megan4977/7404337_RZ_G2_HW/DesignDocs/LiveFireSLA/closebattcontact.jpg

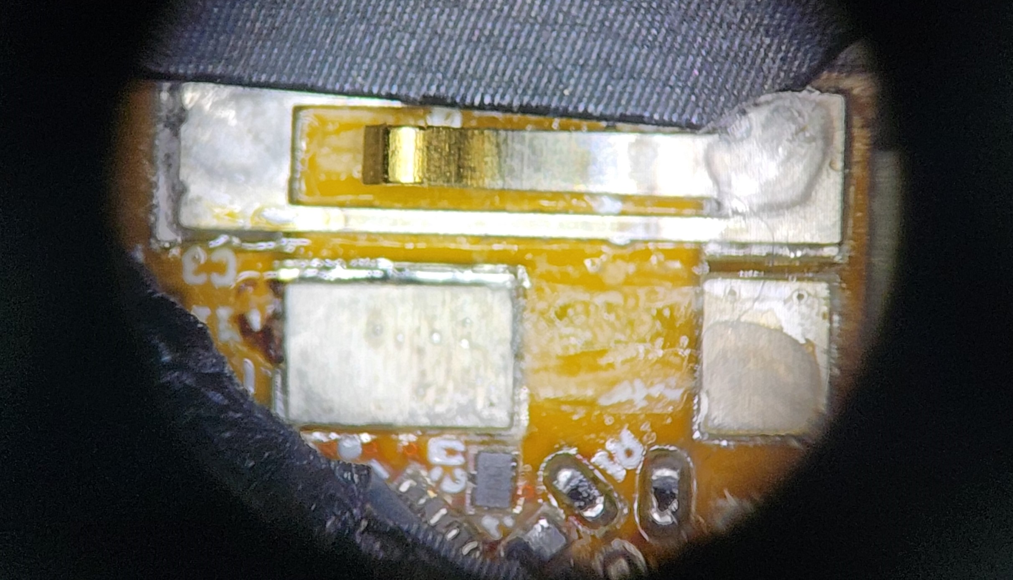
DesignDocs/LiveFireSLA/closebattcontact.jpg
