megan4977/7404337_RZ_G2_HW/AltiumProject/Project Outputs/FAB/ReadMe.txt

The FabOutputs.PDF does not show the solder mask (coverlay) cut outs or solder paste for D1. Please refer to gerbers.
The 3D images in FabOutputs.PDF do not show the cutout in the stiffener. Please refer to the drawing for that info.
The Gerbers do not show the stiffener cutout please refer to the drawing for that info.
