megan4977/7404337_RZ_G2_HW/AltiumProject/Project Outputs/7404337_RZ_G2_DesignRule.PDF

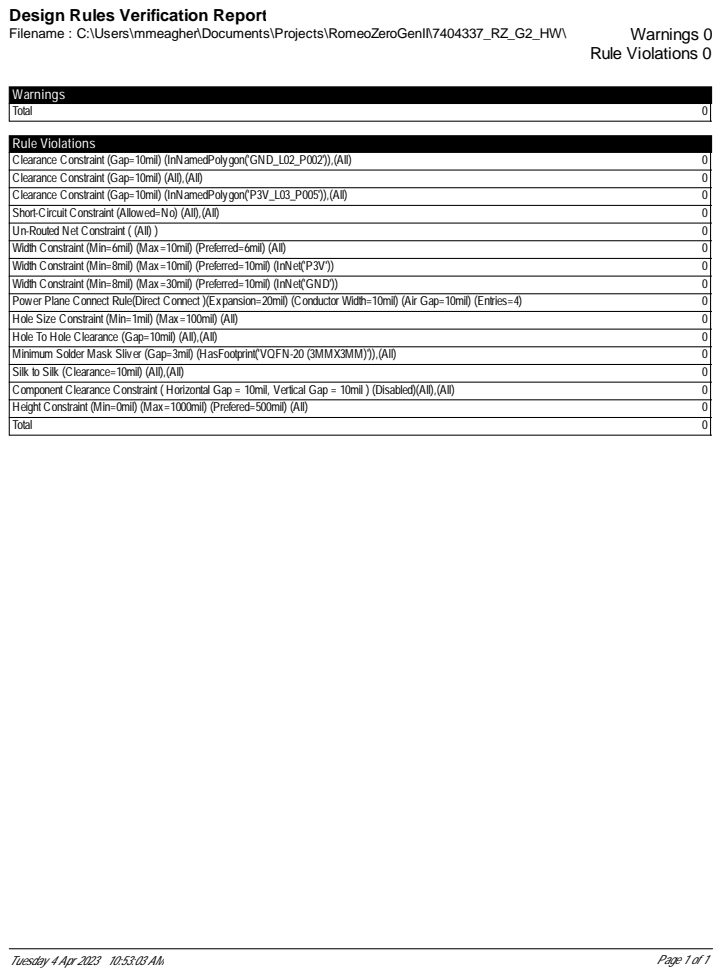
[picture p19: page 1]

Design Rules Verification Report

### Electrical Rules Check Report

Class | Document | Message
Warning | 7404337_RZ_G2.SchDoc | Off grid Pin J2-3 at 1849.537mil,5103.987mil
Warning | 7404337_RZ_G2.SchDoc | Off grid Pin J2-4 at 1853.661mil,5002.953mil
Tuesday 4 Apr 2023 10:53:04 AM | Page 1 of 1

No differences were detected.
