megan4977/7404337_RZ_G2_HW/DesignDocs/Stackup_7404337.xls

 |  | A (MAIN) | B (FLEX) | D (LED) |  | A | B | C | D
Layers
Black cover film | PI | YELLOW COVERLAY |  |  | 25 | 25 | 25
 | AD |  |  |  | 25 | 25 | 25
Copper plating 2 | PLATING | 2nd Cu Plating |  |  | 18 | 18 | 18
Copper plating 2 | CU | Electro Deposited Cu |  |  | 18 | 18 | 18
Double-sided substrate (G3/GBL) | PI |  |  |  | 25 | 25 | 25
 | CU | Electro Deposited Cu |  |  | 18 | 18
 | AD |  |  |  | 25 | 25
Copper plating 1 | PI |  | Black Coverlay |  | 25 | 25 | 25 | 25 | 25
Black cover film | AD |  |  |  | 25 | 25 | 25 | 25 | 25
 | PLATING | 1st Cu Plating |  | 1st Cu Plating | 15 | 15 | 15 | 15 | 15
Pure glue | CU | Electro Deposited Cu |  | Electro Deposited Cu | 18 | 18 | 18 | 18 | 18
Double-sided substrate (G3/GBL) | PI |  |  |  | 25 | 25 | 25 | 25 | 25
 | CU | Electro Deposited Cu |  | Electro Deposited Cu | 18 | 18 | 18 |  | 18
 | PLATING | 1st Cu Plating |  | 1st Cu Plating | 15 | 15 | 15 |  | 15
Copper plating 2 | PLATING | 2nd Cu Plating |  | 2nd Cu Plating | 18 | 18 | 18 |  | 18
Yellow cover film | AD |  |  |  | 25 | 25 | 25 | 25 | 25
 | PI | YELLOW COVERLAY | Black Coverlay |  | 25 | 25 | 25 | 25 | 25
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
