megan4977/7404337_RZ_G2_HW/DesignDocs/To Do.xlsx

Need to determine if the restitors R9 and R10 need different values for dot version of board | Done | swapped dot and cd resistors
need to develop FW for ID function to use same FW for dot/vs circle dot | Done | working
Determine if we can use all black coverlay | Done
create a test plan | Done
review open items from the dfmea | Done
never received confirmation on battery hours | Done
Verify what Attiny versions our fw can fit into
test switch mechanicals to make sure we can't push it off the board
Clean up the current FW to be more modular and make sense
put together a cost analysis of having vendor program and test vs the line programming and testing
move silk to bottom of stiffenere instead of bottom of board
add test point for checking accelerometer
get current measurements
Test out current draw when setting up pins to be outputs driven low or high vs setting to inputs with input buffer disabled and I think you also have to enable the pull up
remove componenets on dot board and test fully
in reticle.c enable LED needs max turned of for unused segments this might already be handled in set Max gear double check on actual board
Boards wrong color
Boards not trimmed at top
Under accelrometed doesn’t have mask not sure if it can
Pin not attached to anything come of easy and need anchor
Transitor needs pin 1 silk
All pin 1 silks need better marking
Possibly add anchoring to the battery pads
Modify the coverlay cutouts to provide anchors see image
Get John a board with new FW to check
See if this code can fit into other Attiny's if so complile FW for it
make sure drawing shows sticker on LED
need to check with don on how to fix drill chart
make sure that the pin setup is correct for the inputs lowest current mode don't want issues like auto off
need to add testing CD dot and circle all separately on the test plan
dot is'nt showing up on the lowest setting when in dot only is on for CD
dot looks like it still has some leakage on PQ5 especially if you look at the low settings on a black background
test out the hardware.c settings
need test instructions
Update layout with drews last drawing that include the cutout then send him step
upate the transistor land pattern with the drawings herb sent
Fix FW pin setup
