megan4977/7404337_RZ_G2_HW/DesignDocs/LiveFireSLA/CloseR.jpg

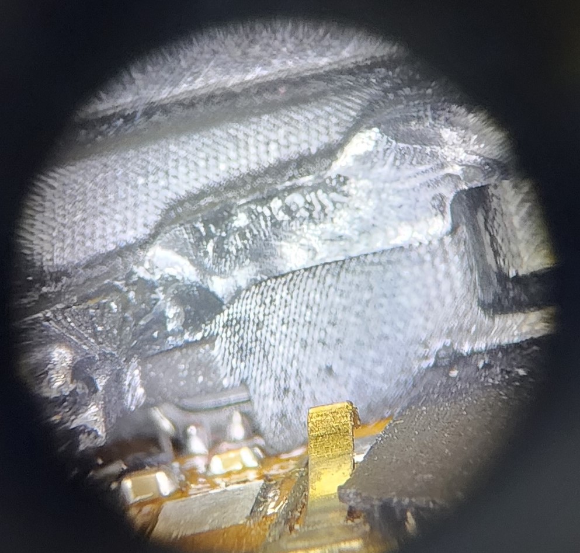
DesignDocs/LiveFireSLA/CloseR.jpg
