megan4977/7404337_RZ_G2_HW/DesignDocs/LiveFireSLA/fullcase.jpg

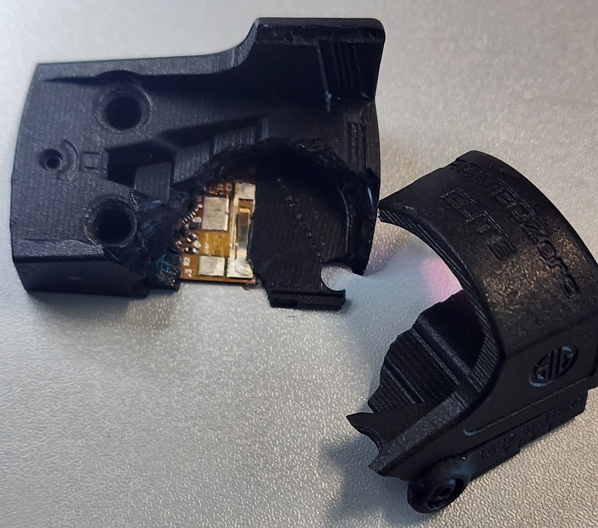
DesignDocs/LiveFireSLA/fullcase.jpg
