megan4977/7404337_RZ_G2_HW/DesignDocs/LiveFireSLA/necktwisted.jpg

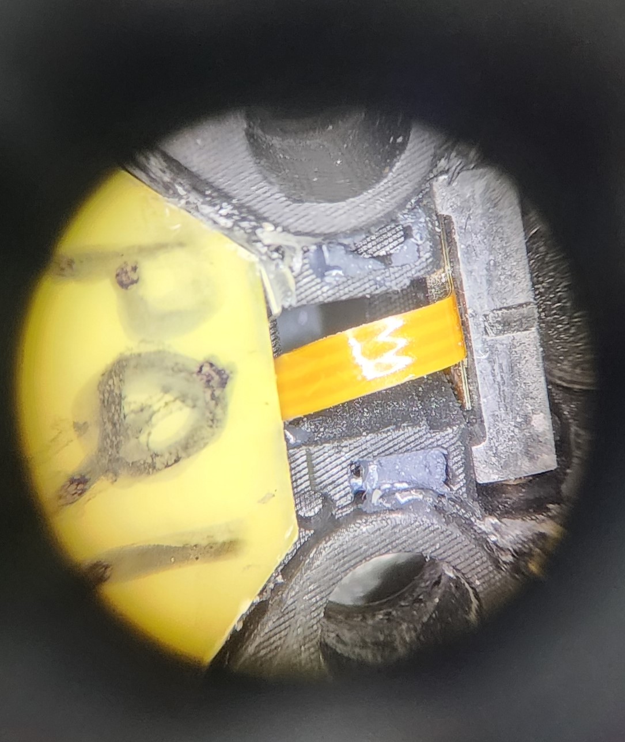
DesignDocs/LiveFireSLA/necktwisted.jpg
