megan4977/7404337_RZ_G2_HW/DesignDocs/LiveFireSLA/partial case.jpg

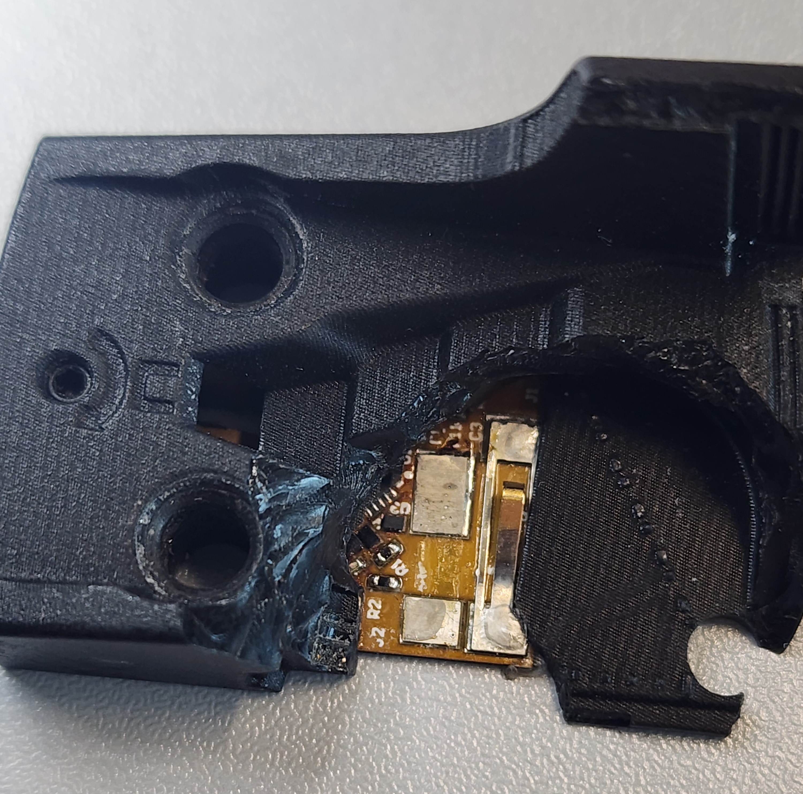
DesignDocs/LiveFireSLA/partial case.jpg
