megan4977/7404337_RZ_G2_HW/DesignDocs/summitLayout.jpg

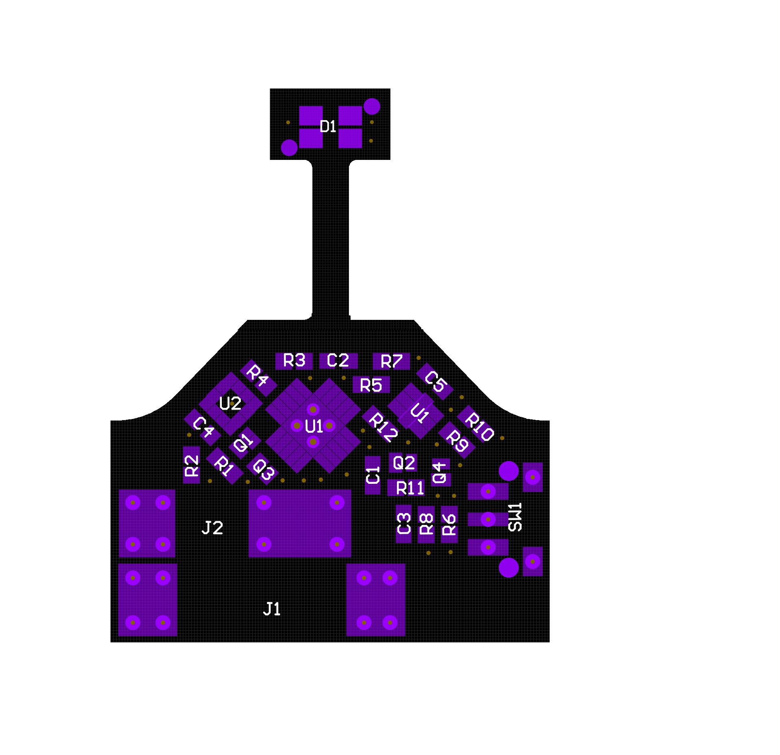
DesignDocs/summitLayout.jpg
