megan4977/7404337_RZ_G2_HW/AltiumProject/Project Outputs/7404337-01_3MOA/ASSY/Bill of Materials-7404337_RZ_G2(7404337-01_3MOA).xlsx

Designator | Quantity | Description | Manufacturer | Value | MPN | Distributor | DPN
C1 | 1 | CAP CER 10UF 10V 20% X5R 0402 | Samsung | 10uF/10V | CL05A106MP5NUNC | Digi-key | 1276-1450-2-ND
C3 | 1 | CAP CER 0.047UF 25V X7R 0402 .55mm max | Murata | 47nF | GRM155R71E473KA88D | Digi-key | 490-3254-2-ND
C4, C5 | 2 | CAP CER 0.1UF 16V X7R 0402 | Murata | 0.1uF | GRM155R71C104KA88D | Digi-key | 490-3261-2-ND
D1 | 1 | LED Jenoptik 25um red | Jenoptik |  | ELM-650-992-025-2 | Jenoptik | ELM-650-992-025-2
FW1 | 1 | FW for 7404337 Romeo Zero Gen II
J1 | 1 | Battery contact, Kyocera, 70-9155-001-615-004 | Kyocera | R0 contact pos | 70-9155-001-615-004
J2 | 1 | Sig Custom Battery contact, custom RZGENII CR1632 Positive | SIG | R0 contact pos | 7401598
J3 | 1 | Connector for pwr, gnd, prgm, sw, accel
Q3, Q4 | 2 | MOSFET P-CH 20V 770MA 3DFN | Diodes Incorporated |  | DMP21D0UFB4-7B |  | MOSFET P-CH 20V 770MA 3DFN
R3, R4 | 2 | RES 4.7K OHM 1% 1/16W 0402 | Yageo | 4.7K | RC0402JR-074K7L | Digi-key | 311-4.7KJRTR-ND
R6 | 1 | RES 3M OHM 5% 1/16W 0402 100ppm | Yageo | 3M | RC0402JR-073ML | Digi-key | 311-3.0MJRTR-ND
R7, R8 | 2 | RES 1M OHM 5% 1/16W 0402 100ppm | Yageo | 1M | RC0402JR-071ML | Digi-key | 311-1.0MJRTR-ND
R9 | 1 | RES SMD 1.02K OHM 1% 1/16W 0402 | Yageo | 1.02K | RC0402FR-071K02L | Digi-key | YAG3029CT-ND
R10 | 1 | 80.6 kOhms ±1% 0.063W, 1/16W Chip Resistor 0402 | Yageo | 80.6K | RC0402FR-0780K6L | Digi-key | 311-80.6KLRCT-ND
R11, R12 | 2 | RES 0OHM 1% 1/16W 0402 | Yageo | 0 | RC0402JR-070RL | Digi-key
R13 | 1 | RES SMD 20K OHM 1% 1/16W 0402 | Yageo | 20K | RC0402FR-0720KL | Digi-key | 311-20.0KLRCT-ND
SW1 | 1 | SWITCH TACTILE SPST-NO 0.05A 12V
U1 | 1 | IC MCU 8BIT 16KB FLASH 20VQFN | Microchip | ATTINY1616 | ATTINY1616-MNR | Digikey | ATTINY1616-MNRCT-ND
U2 | 1 | Accelerometer X, Y, Z Axis 12VFLGA | STMicroelectronics |  | LIS2DE12TR | Digi-key | 497-15997-1-ND
U3 | 1 | IC CMOS 2 CIRCUIT 8X2QFN | Texas Instruments | TLV8542 | TLV8542RUGR | Digikey | 296-50282-1-ND
