megan4977/7404337_RZ_G2_HW/AltiumProject/7404337_RZ_G2.step

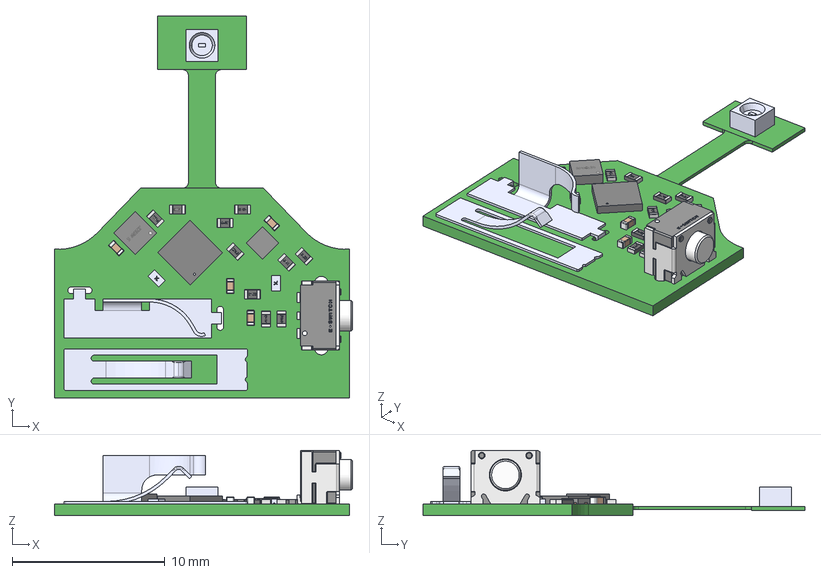
[picture p25: CAD file, 2023-04-04]
AltiumProject/7404337_RZ_G2.step
19.5 x 25.0 x 4.26 mm
VQFN20_3X3_MCH
7404338 REV00 230315
User Library-0402R x 10
RZCD_ELM65099212
TLV8542RUG0008A
CAP_0402 x 4
LIS2DW12
button
terminals
logo
SOT883B4 LF x 2
SOT883B Mold body x 2
70-9155-001-615-00X
