megan4977/7404337_RZ_G2_HW/AltiumProject/Import_Export/7404337_RZ_230315.STEP

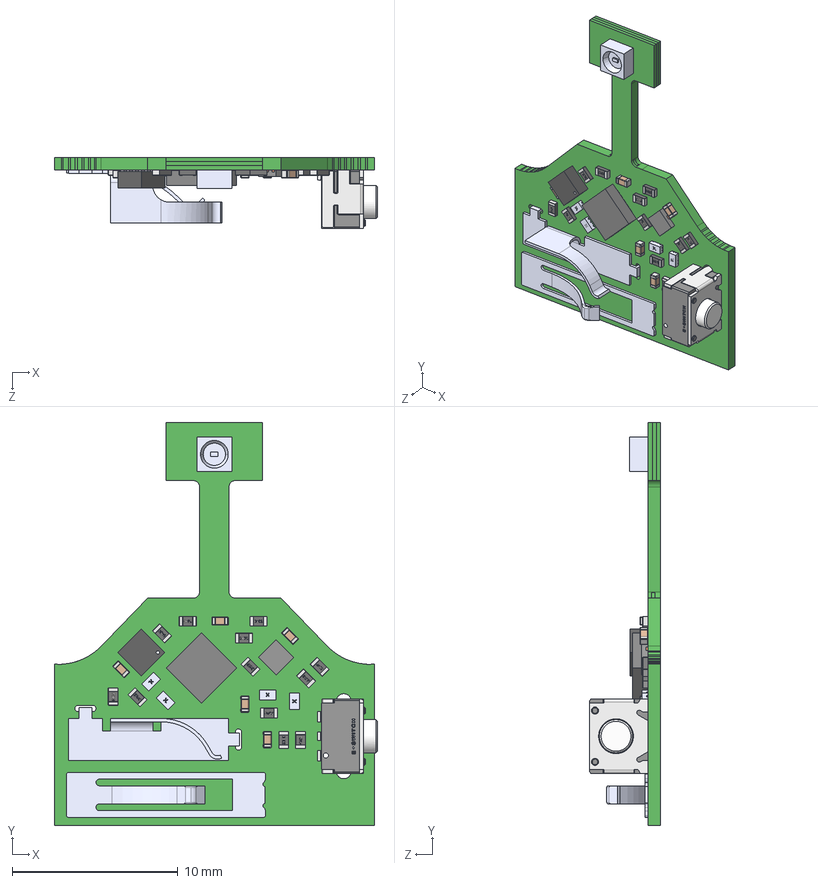
[picture p26: CAD file, 2023-04-04]
AltiumProject/Import_Export/7404337_RZ_230315.STEP
19.5 x 24.3 x 4.29 mm
RZCD_ELM65099212.step
User Library-0402R.step x 12
TLV8542RUG0008A.step
CAP_0402.step x 5
VQFN20_3X3X0R9.step
SOT883B4 LF.step x 4
SOT883B Mold body.step x 4
STLIS2DE12LGA12_2x2x1.step
body.step
shell.step
button.step
terminals.step
logo.step
70-9155-001-615-00X.step
