megan4977/7404337_RZ_G2_HW/AltiumProject/Import_Export/Models/7404338 REV00.STEP

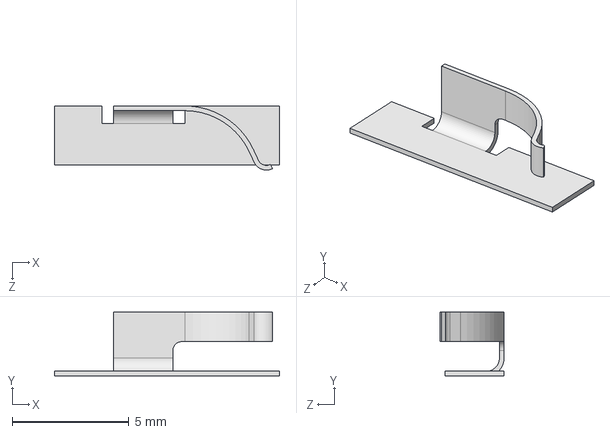
[picture p27: CAD file, 2023-04-04]
AltiumProject/Import_Export/Models/7404338 REV00.STEP
9.65 x 2.74 x 2.75 mm
