megan4977/7404337_RZ_G2_HW/AltiumProject/Import_Export/7404338 REV00 230315.STEP

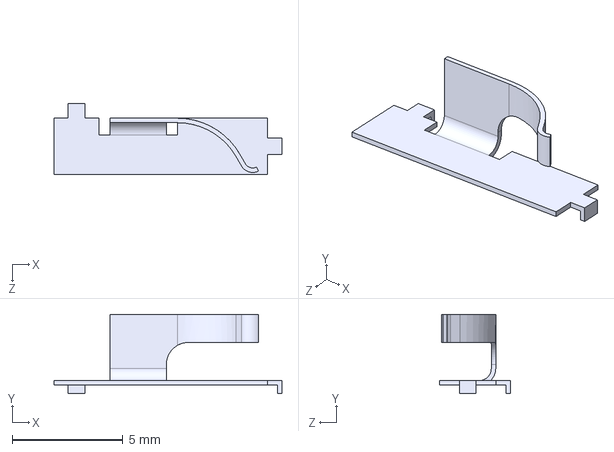
[picture p28: CAD file, 2023-04-04]
AltiumProject/Import_Export/7404338 REV00 230315.STEP
10.3 x 3.58 x 3.20 mm
