megan4977/7404337_RZ_G2_HW/AltiumProject/Import_Export/7404337 221219.DXF

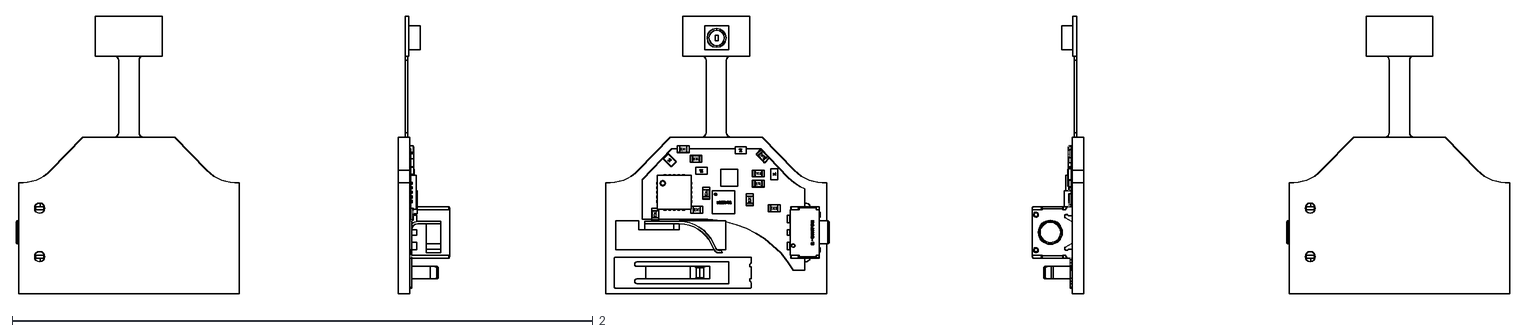
[picture p29: CAD file, 2023-04-04]
AltiumProject/Import_Export/7404337 221219.DXF
5.14 x 0.957
