megan4977/7404337_RZ_G2_HW/AltiumProject/Import_Export/7404337 221212.DXF

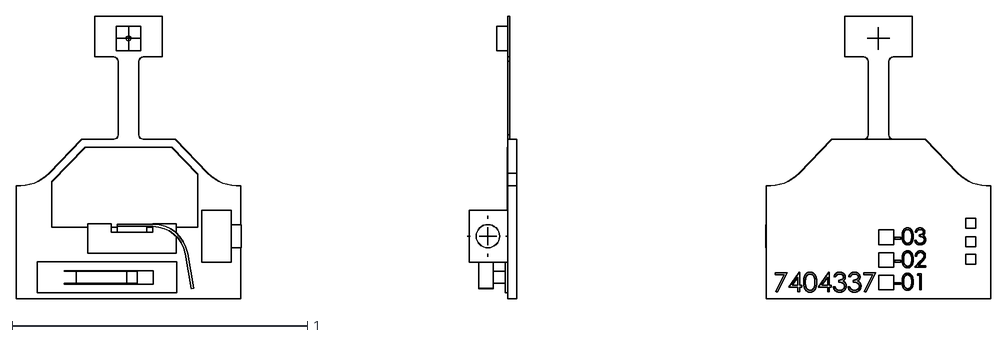
[picture p31: CAD file, 2023-04-04]
AltiumProject/Import_Export/7404337 221212.DXF
3.30 x 0.957
