megan4977/7404337_RZ_G2_HW/AltiumProject/Import_Export/7404337 230327.DXF

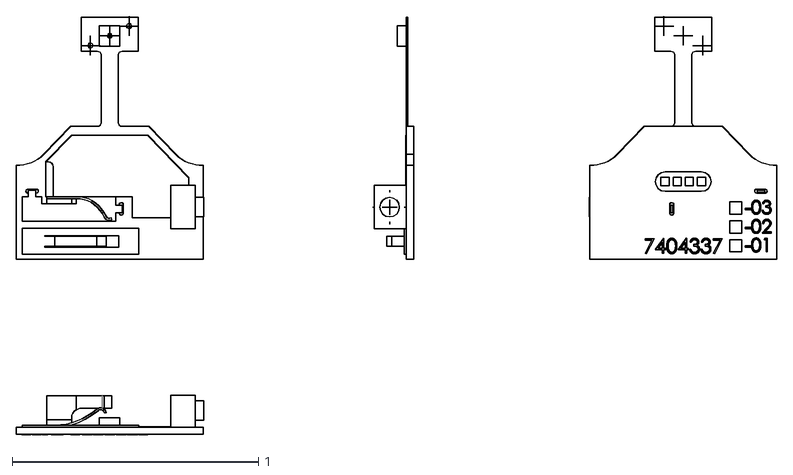
[picture p32: CAD file, 2023-04-04]
AltiumProject/Import_Export/7404337 230327.DXF
3.09 x 1.70
