megan4977/7404337_RZ_G2_HW/AltiumProject/Import_Export/7404337 REV00.DXF

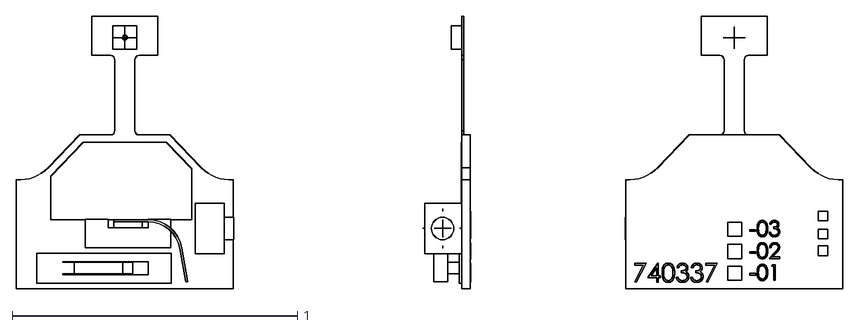
[picture p34: CAD file, 2023-04-04]
AltiumProject/Import_Export/7404337 REV00.DXF
2.90 x 0.957
