megan4977/7404337_RZ_G2_HW/AltiumProject/Import_Export/7404337_RZ_G2_PADS.DXF

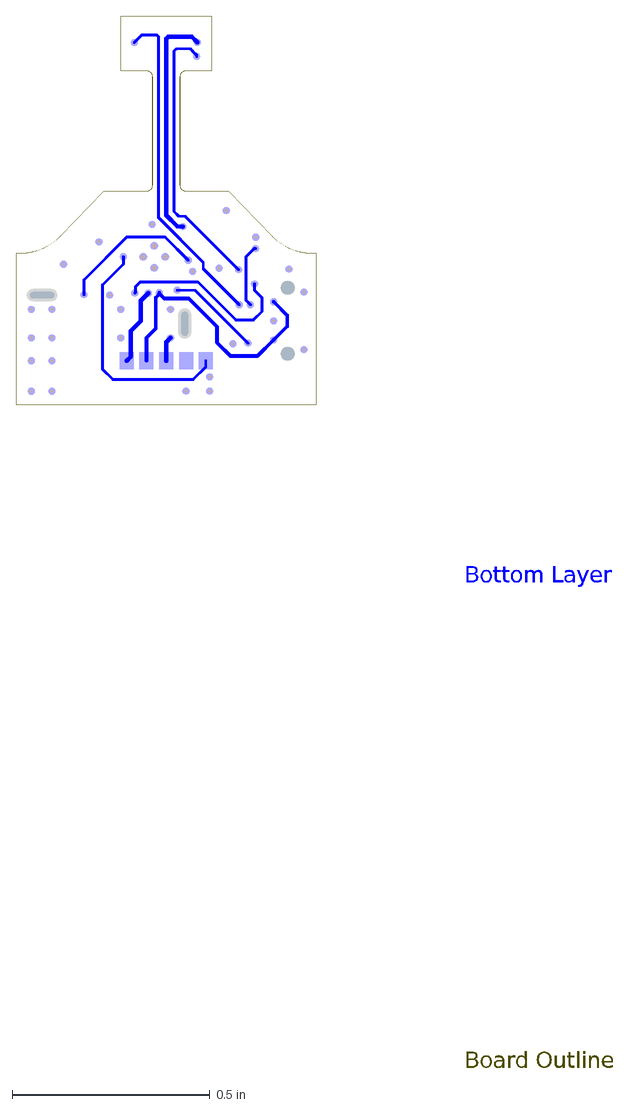
[picture p35: CAD file, 2023-04-04]
AltiumProject/Import_Export/7404337_RZ_G2_PADS.DXF
Bottom Layer
Board Outline
