megan4977/7404337_RZ_G2_HW/AltiumProject/Import_Export/7404337 REV00 230126.DXF

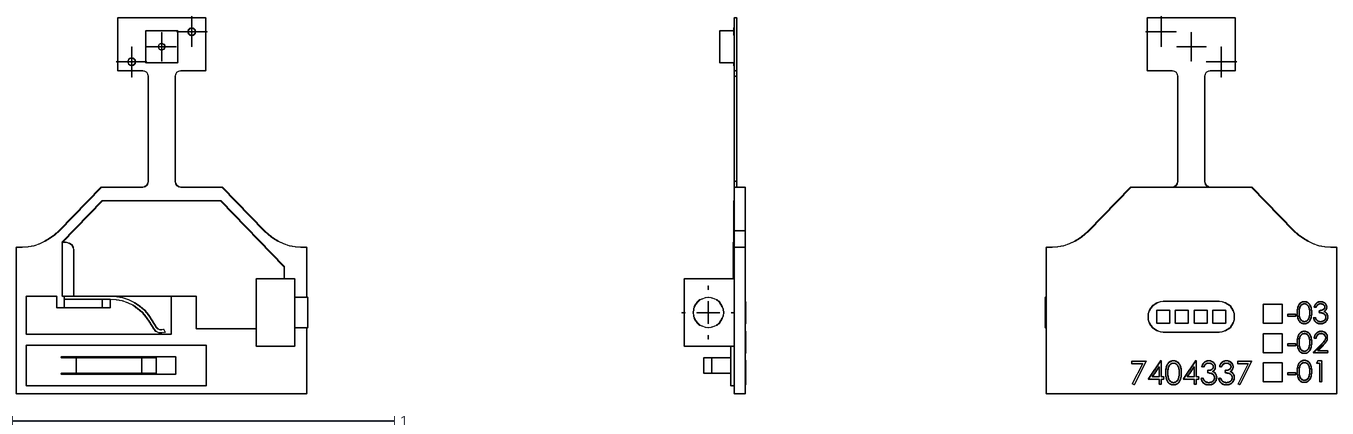
[picture p36: CAD file, 2023-04-04]
AltiumProject/Import_Export/7404337 REV00 230126.DXF
3.45 x 0.987
