megan4977/7404337_RZ_G2_HW/(list of files, cad)

Other CAD files:
AltiumProject/Import_Export/7404337_RZ_G2.step
