megan4977/7404337_RZ_G2_HW/AltiumProject/Project Outputs/7404337-01_3MOA/ASSY/Schematic Prints.PDF

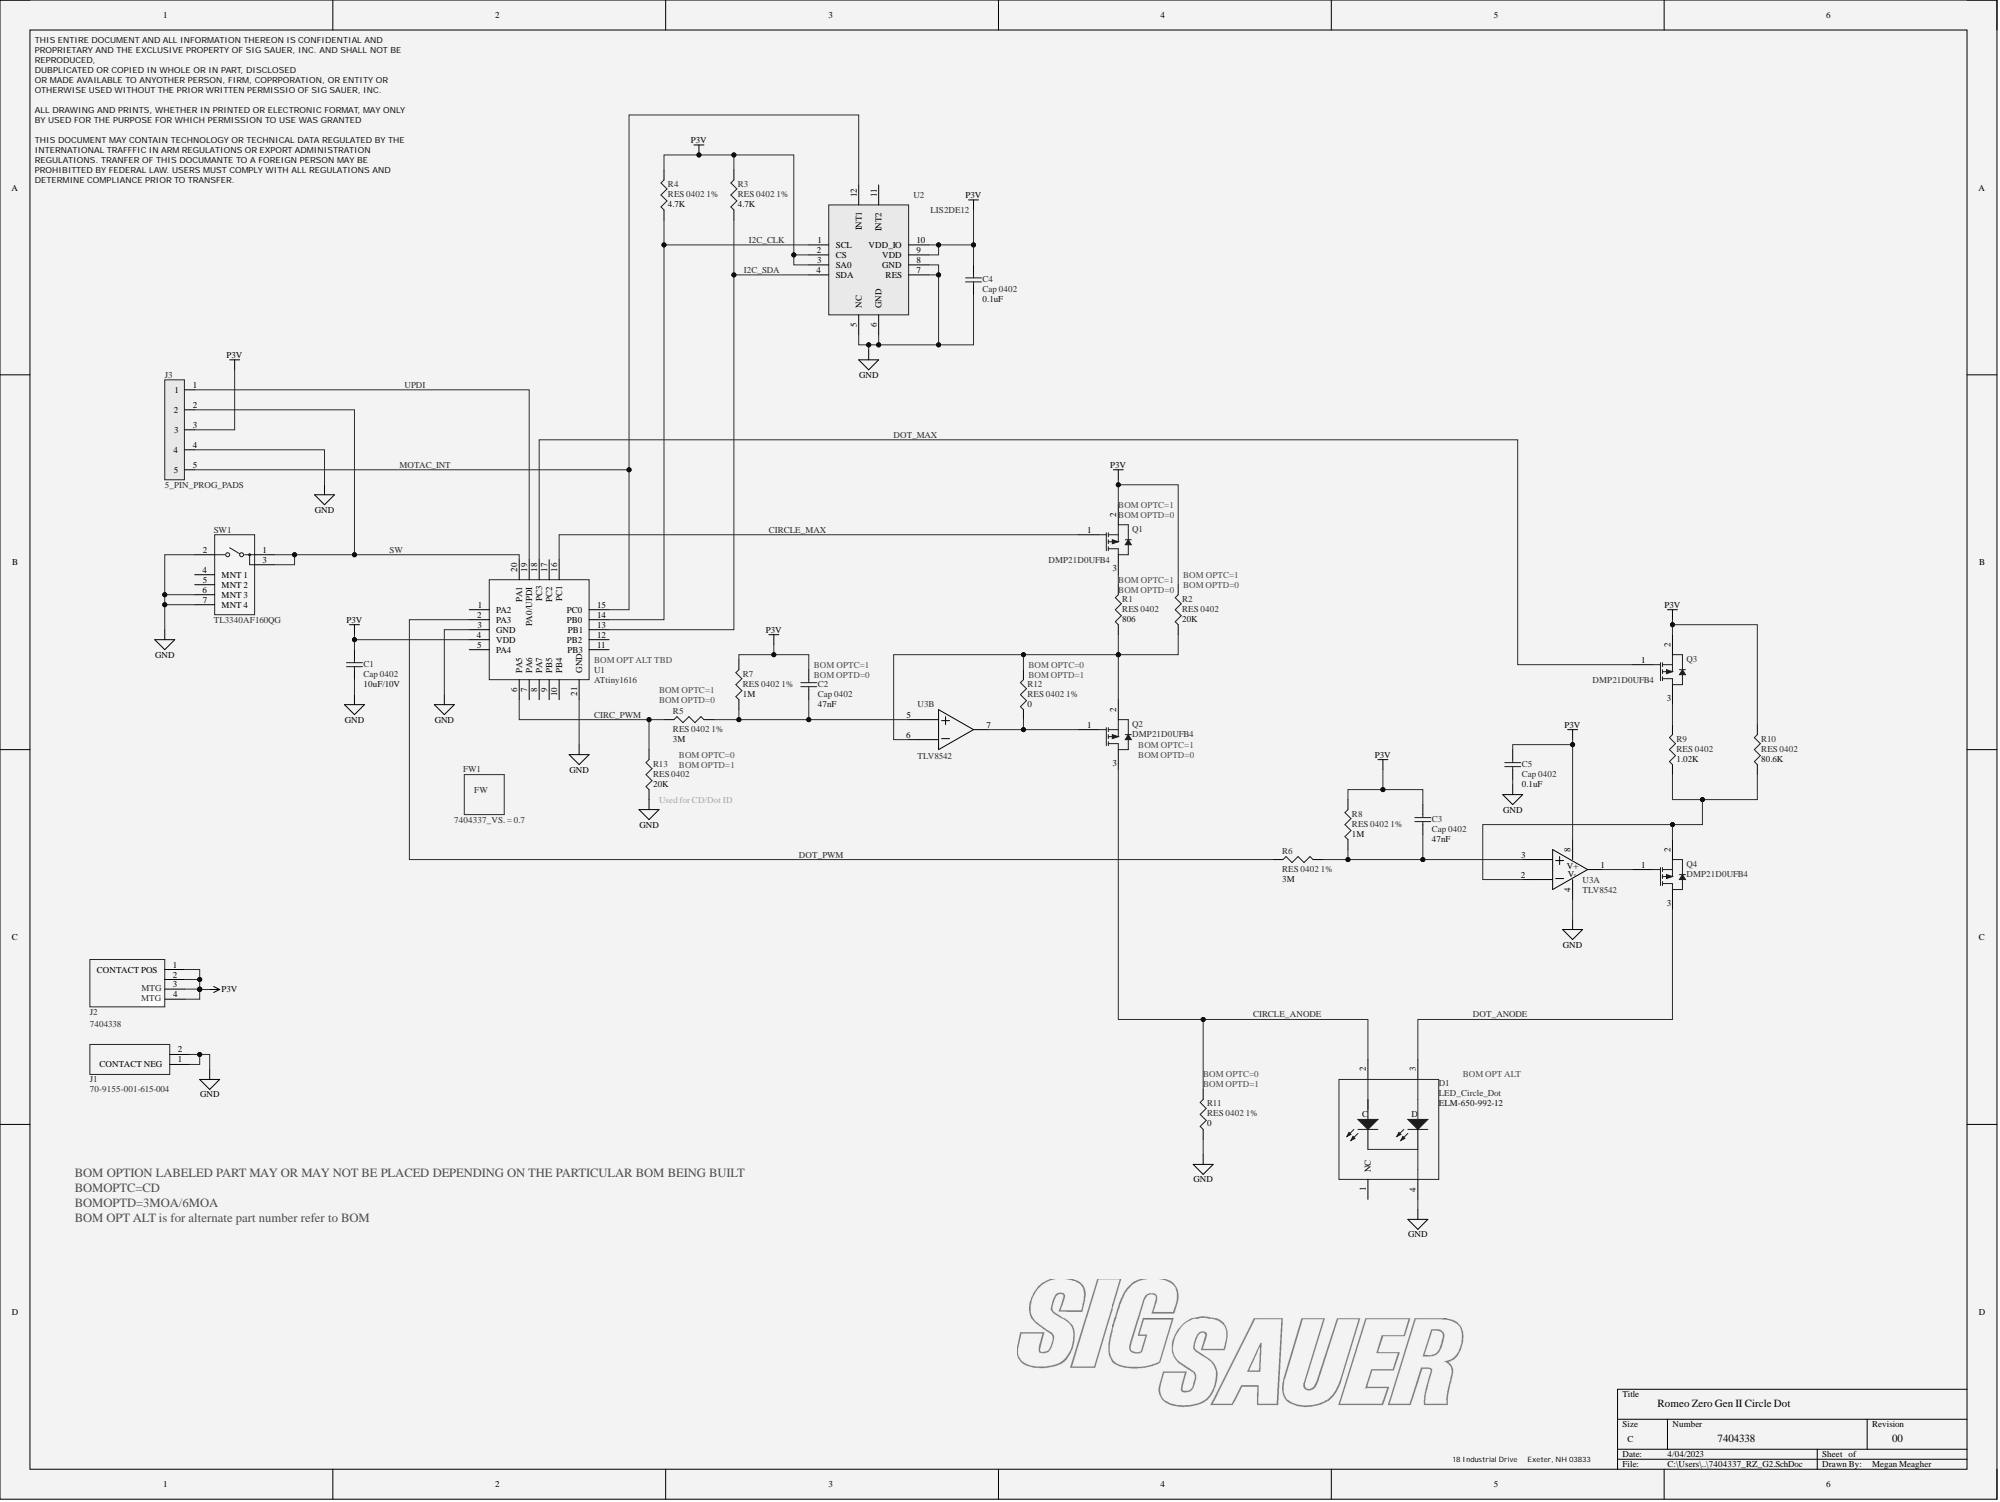
[picture p38: page 1]

THIS ENTIRE DOCUMENT AND ALL INFORMATION THEREON IS CONFIDENTIAL AND
PROPRIETARY AND THE EXCLUSIVE PROPERTY OF SIG SAUER, INC. AND SHALL NOT BE
REPRODUCED,
DUBPLICATED OR COPIED IN WHOLE OR IN PART, DISCLOSED
OR MADE AVAILABLE TO ANYOTHER PERSON, FIRM, COPRPORATION, OR ENTITY OR
OTHERWISE USED WITHOUT THE PRIOR WRITTEN PERMISSIO OF SIG SAUER, INC.

ALL DRAWING AND PRINTS, WHETHER IN PRINTED OR ELECTRONIC FORMAT, MAY ONLY
BY USED FOR THE PURPOSE FOR WHICH PERMISSION TO USE WAS GRANTED

THIS DOCUMENT MAY CONTAIN TECHNOLOGY OR TECHNICAL DATA REGULATED BY THE
INTERNATIONAL TRAFFFIC IN ARM REGULATIONS OR EXPORT ADMINISTRATION
REGULATIONS. TRANFER OF THIS DOCUMANTE TO A FOREIGN PERSON MAY BE
PROHIBITTED BY FEDERAL LAW. USERS MUST COMPLY WITH ALL REGULATIONS AND
DETERMINE COMPLIANCE PRIOR TO TRANSFER.

GND 6 RES 7 GND 8 VDD 9 VDD_IO 10

MNT 1 4 | 3

PA2 1 | PB3 | 11 PB2 12 PB1 13 PB0 14 PC0 15 PC1 16 PC2 17 PC3 18 PA0/UPDI 19 PA1 20

GND 3

Used for CD/Dot ID

BOM OPTION LABELED PART MAY OR MAY NOT BE PLACED DEPENDING ON THE PARTICULAR BOM BEING BUILT
BOMOPTC=CD
BOMOPTD=3MOA/6MOA
BOM OPT ALT is for alternate part number refer to BOM

Romeo Zero Gen II Circle Dot
