megan4977/7404337_RZ_G2_HW/AltiumProject/Project Outputs/FAB/FabOutputs.PDF

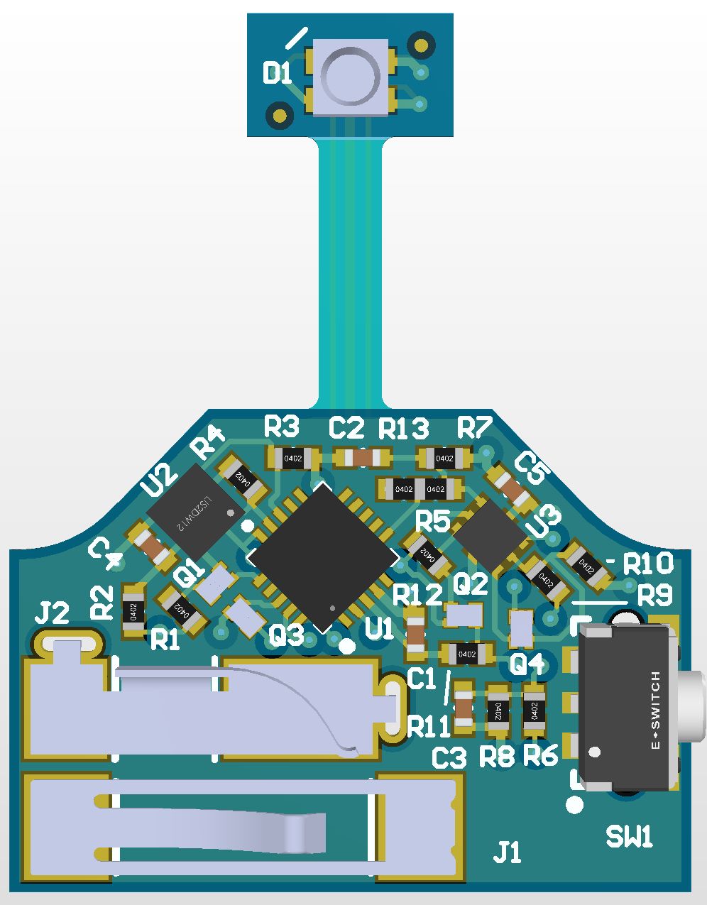
[picture p39: page 1]

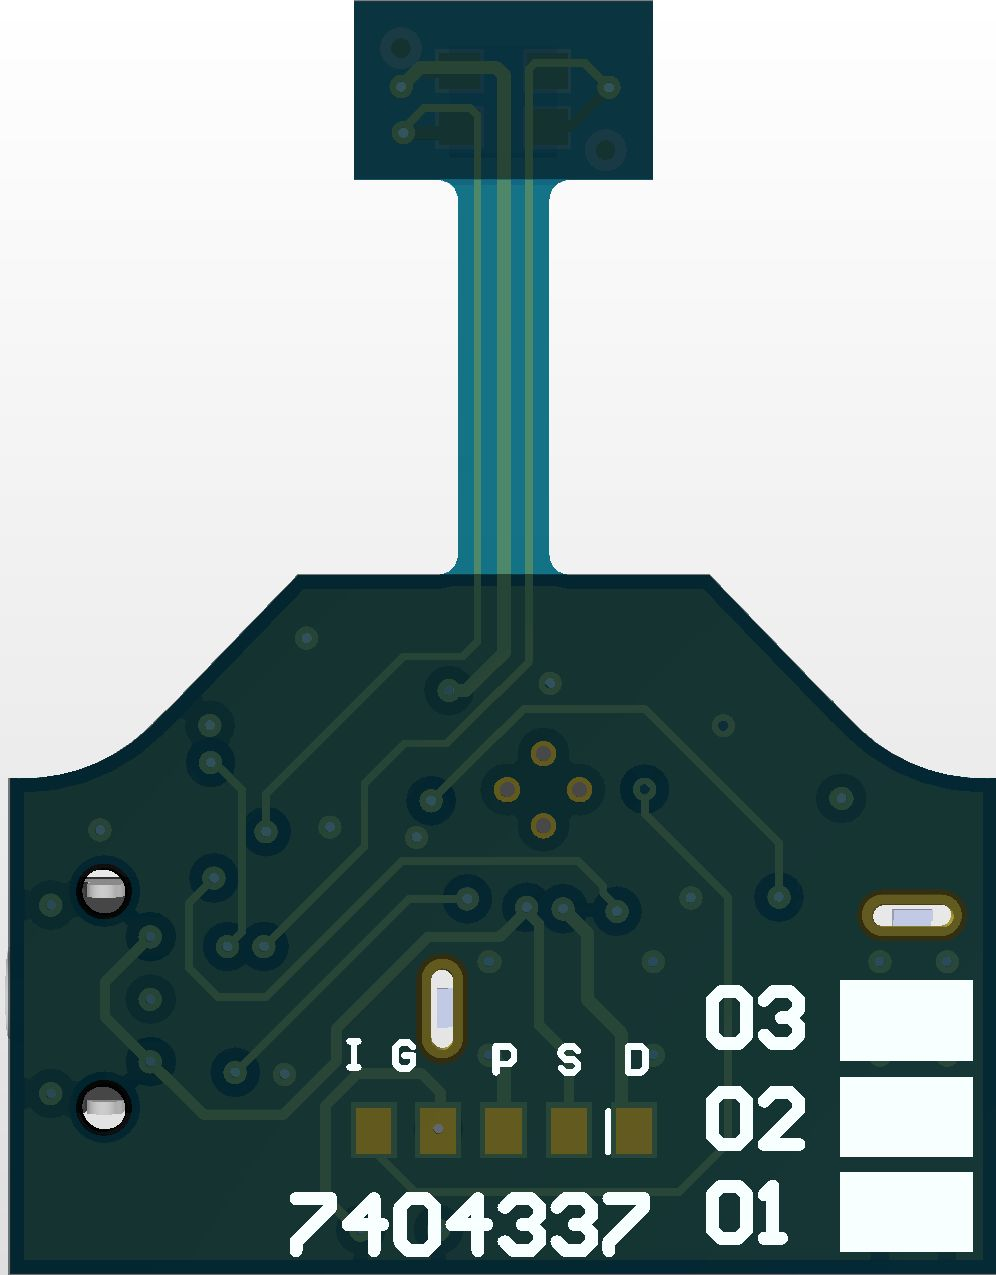
[picture p40: page 2]

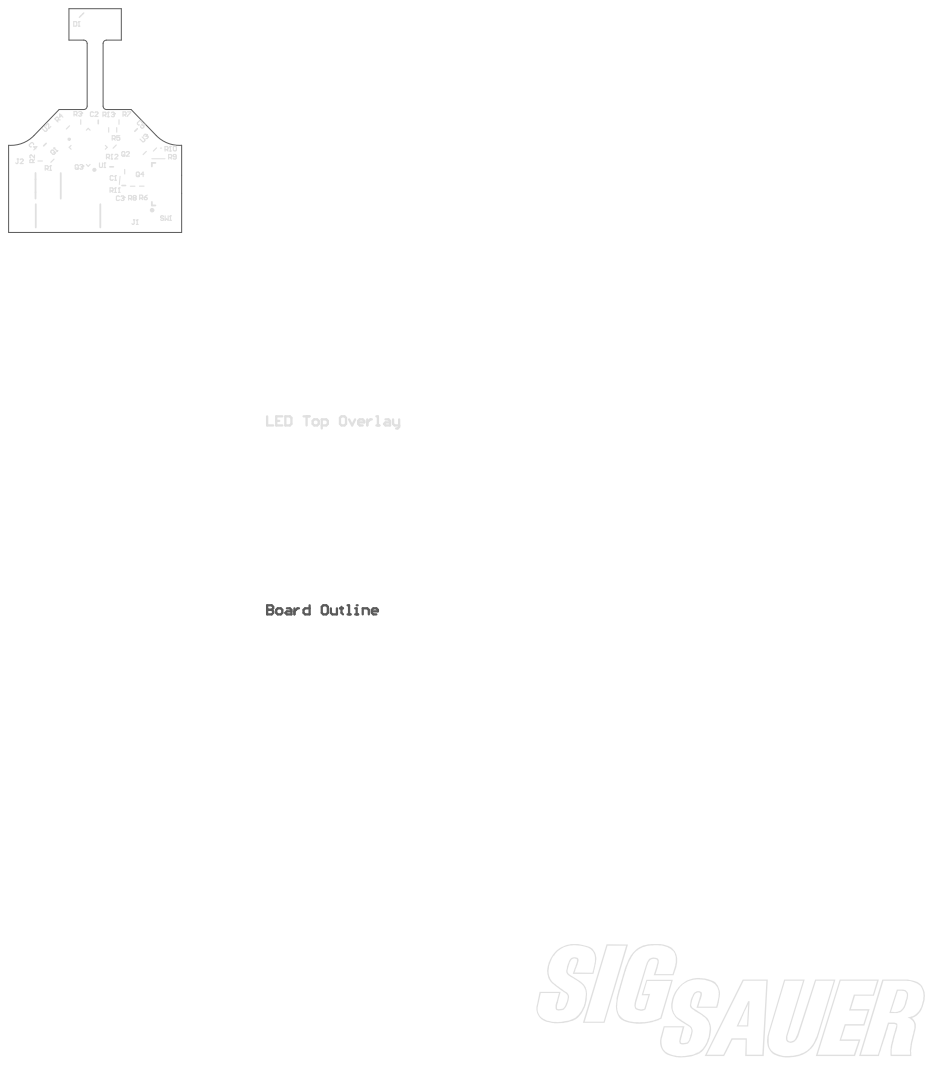
[picture p41: page 3]

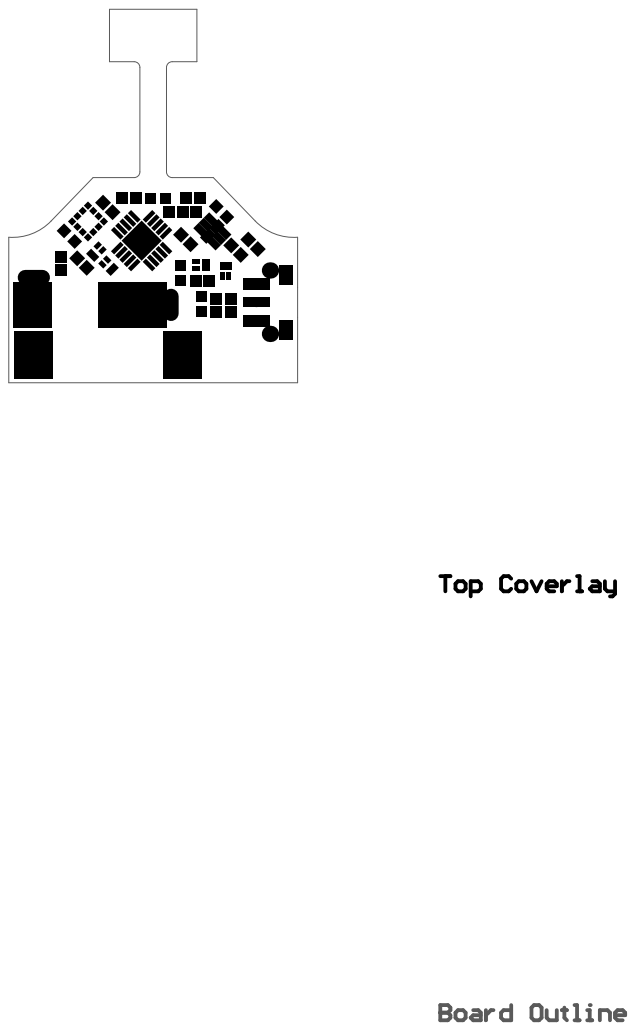
[picture p42: page 4]

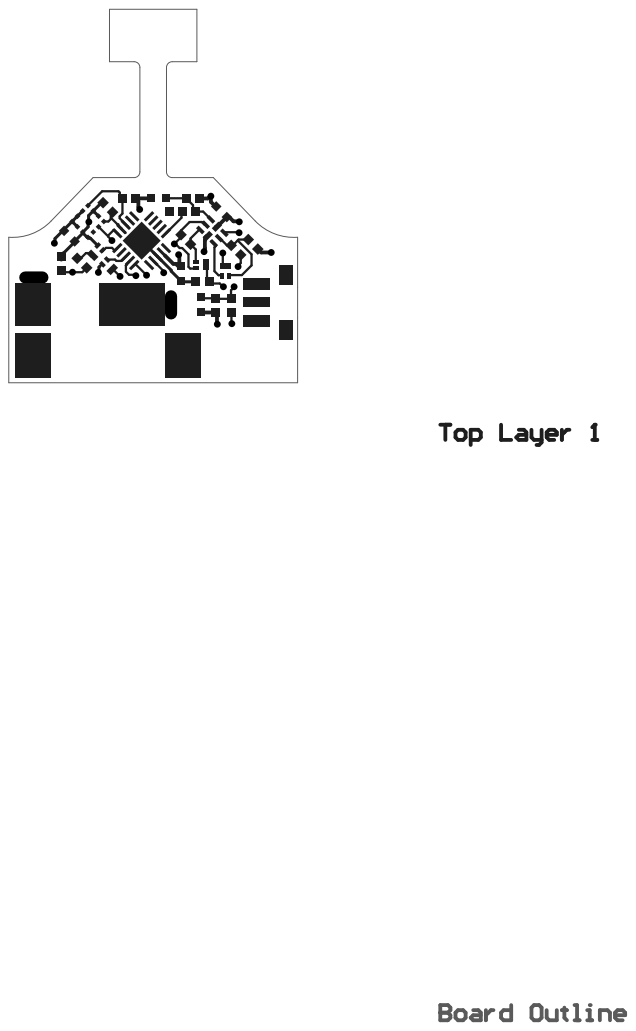
[picture p43: page 5]

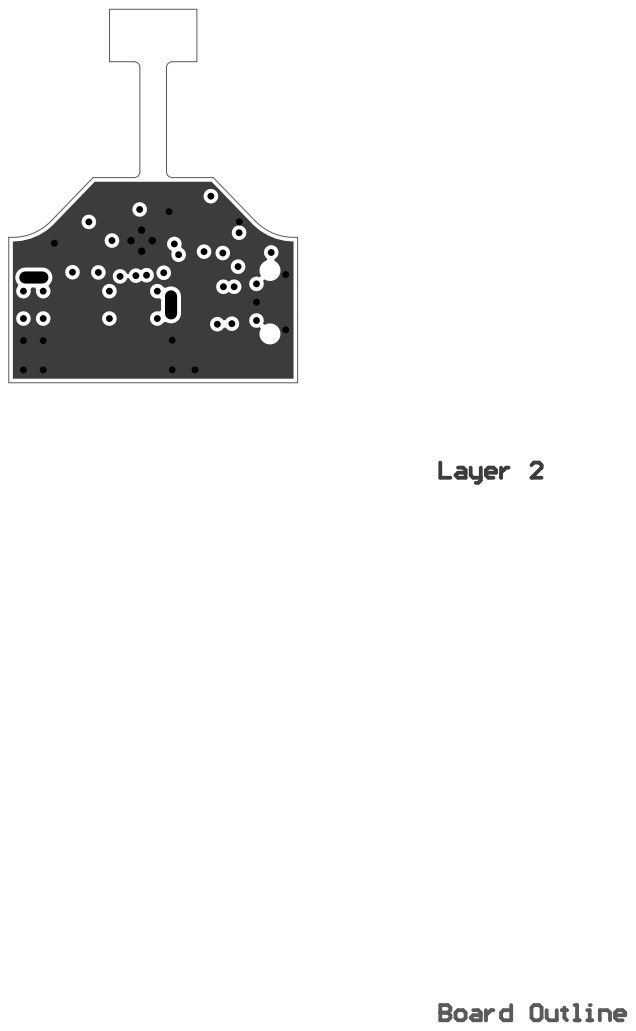
[picture p44: page 6]

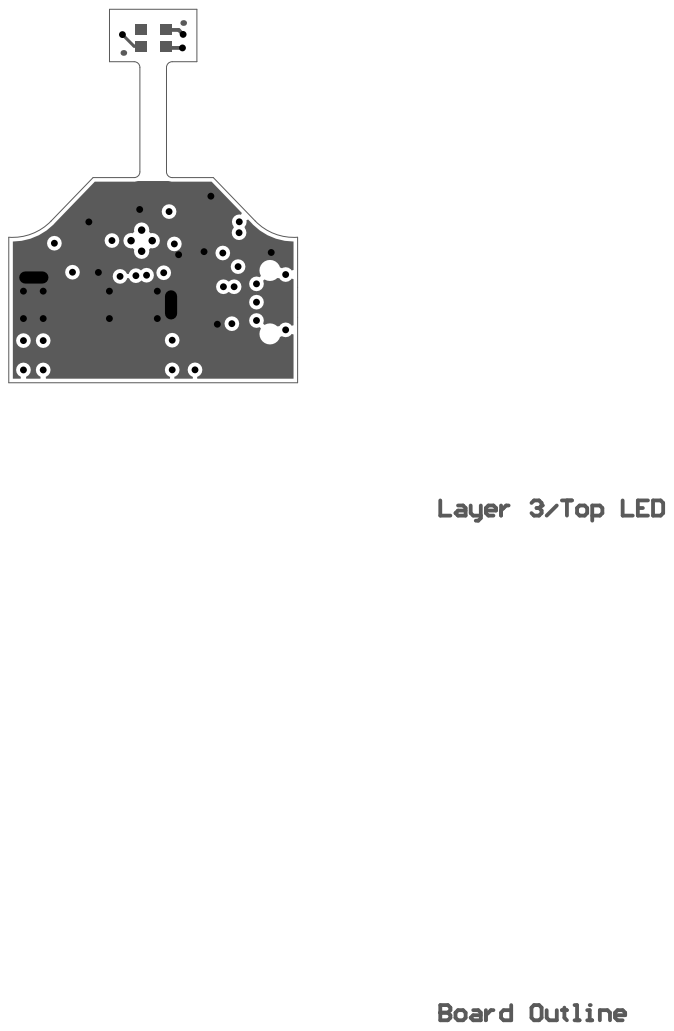
[picture p45: page 7]

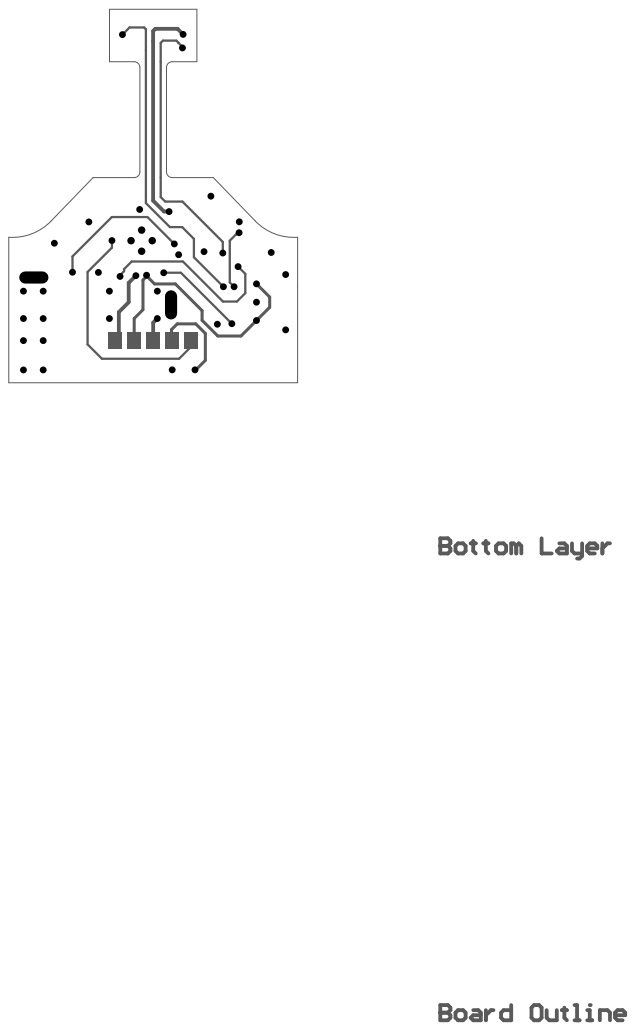
[picture p46: page 8]

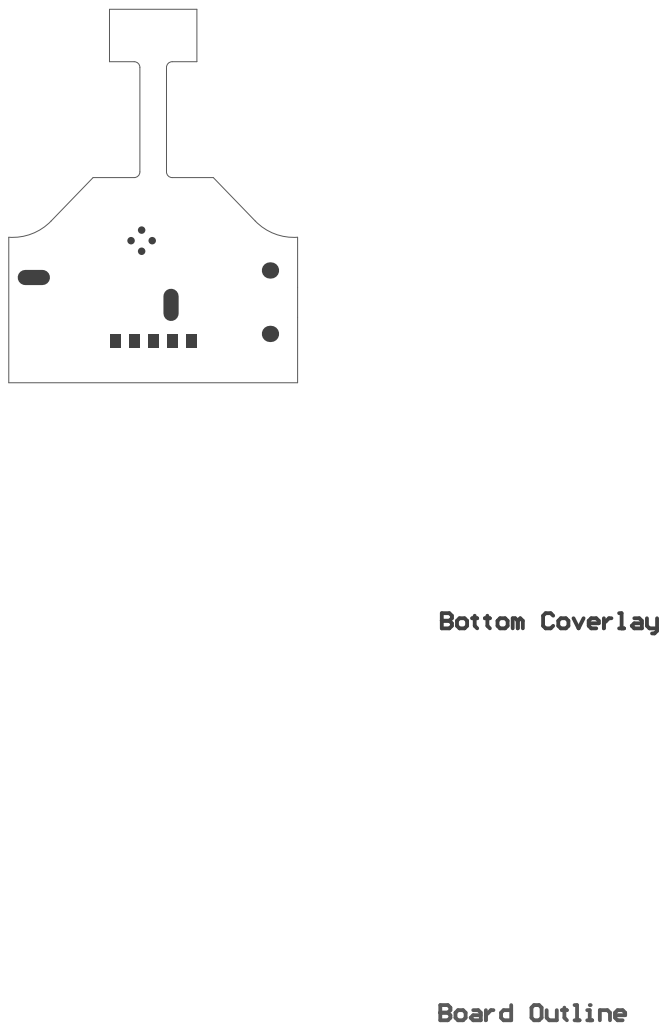
[picture p47: page 9]

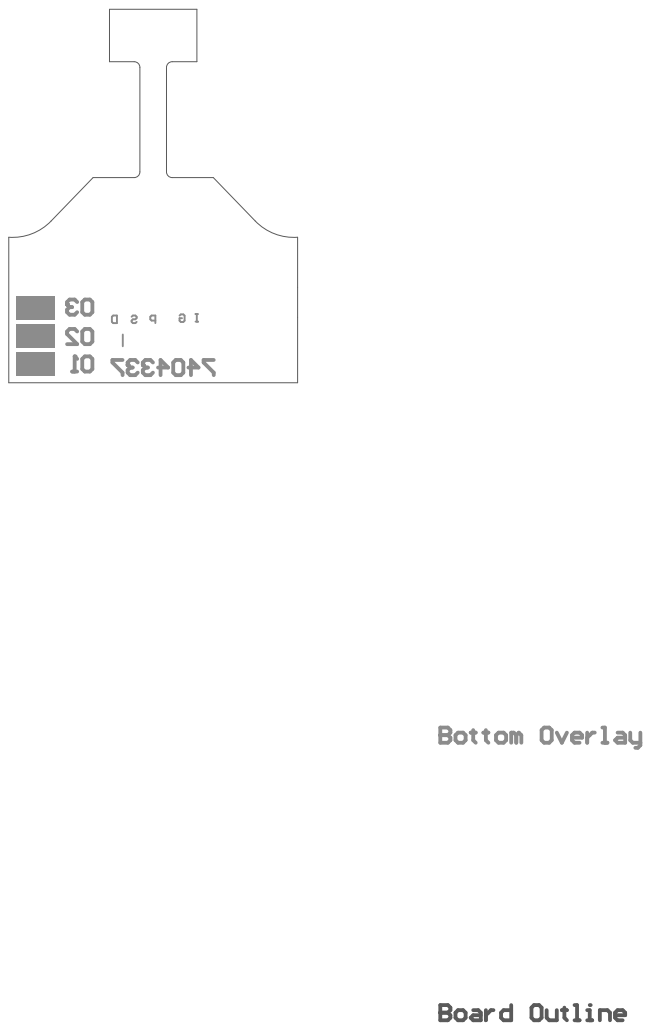
[picture p48: page 10]

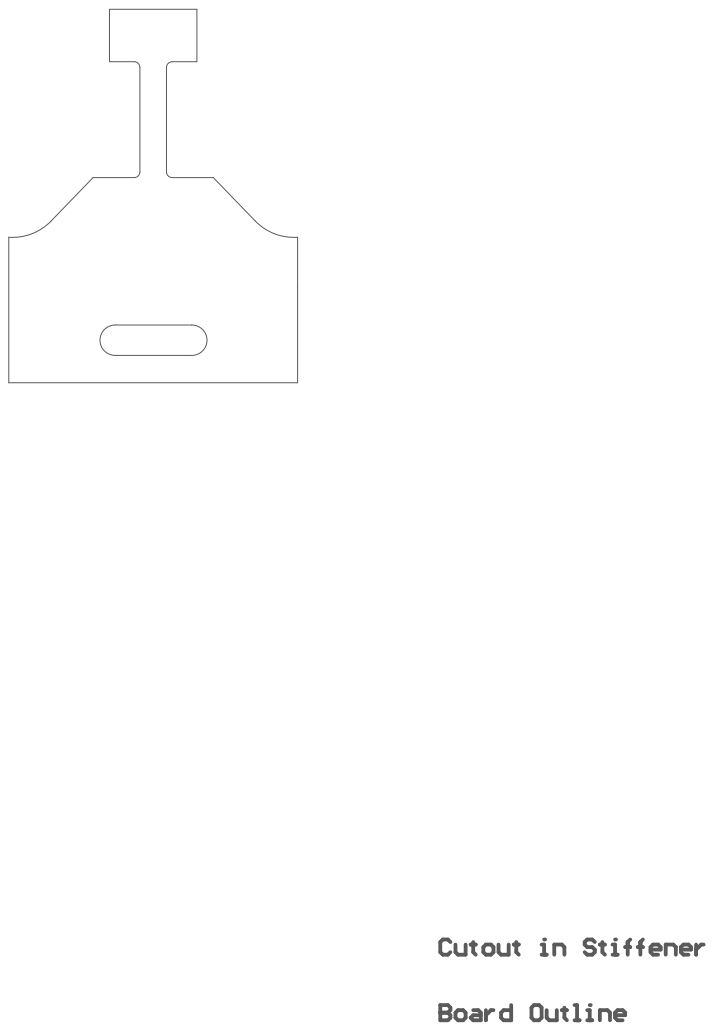
[picture p49: page 11]

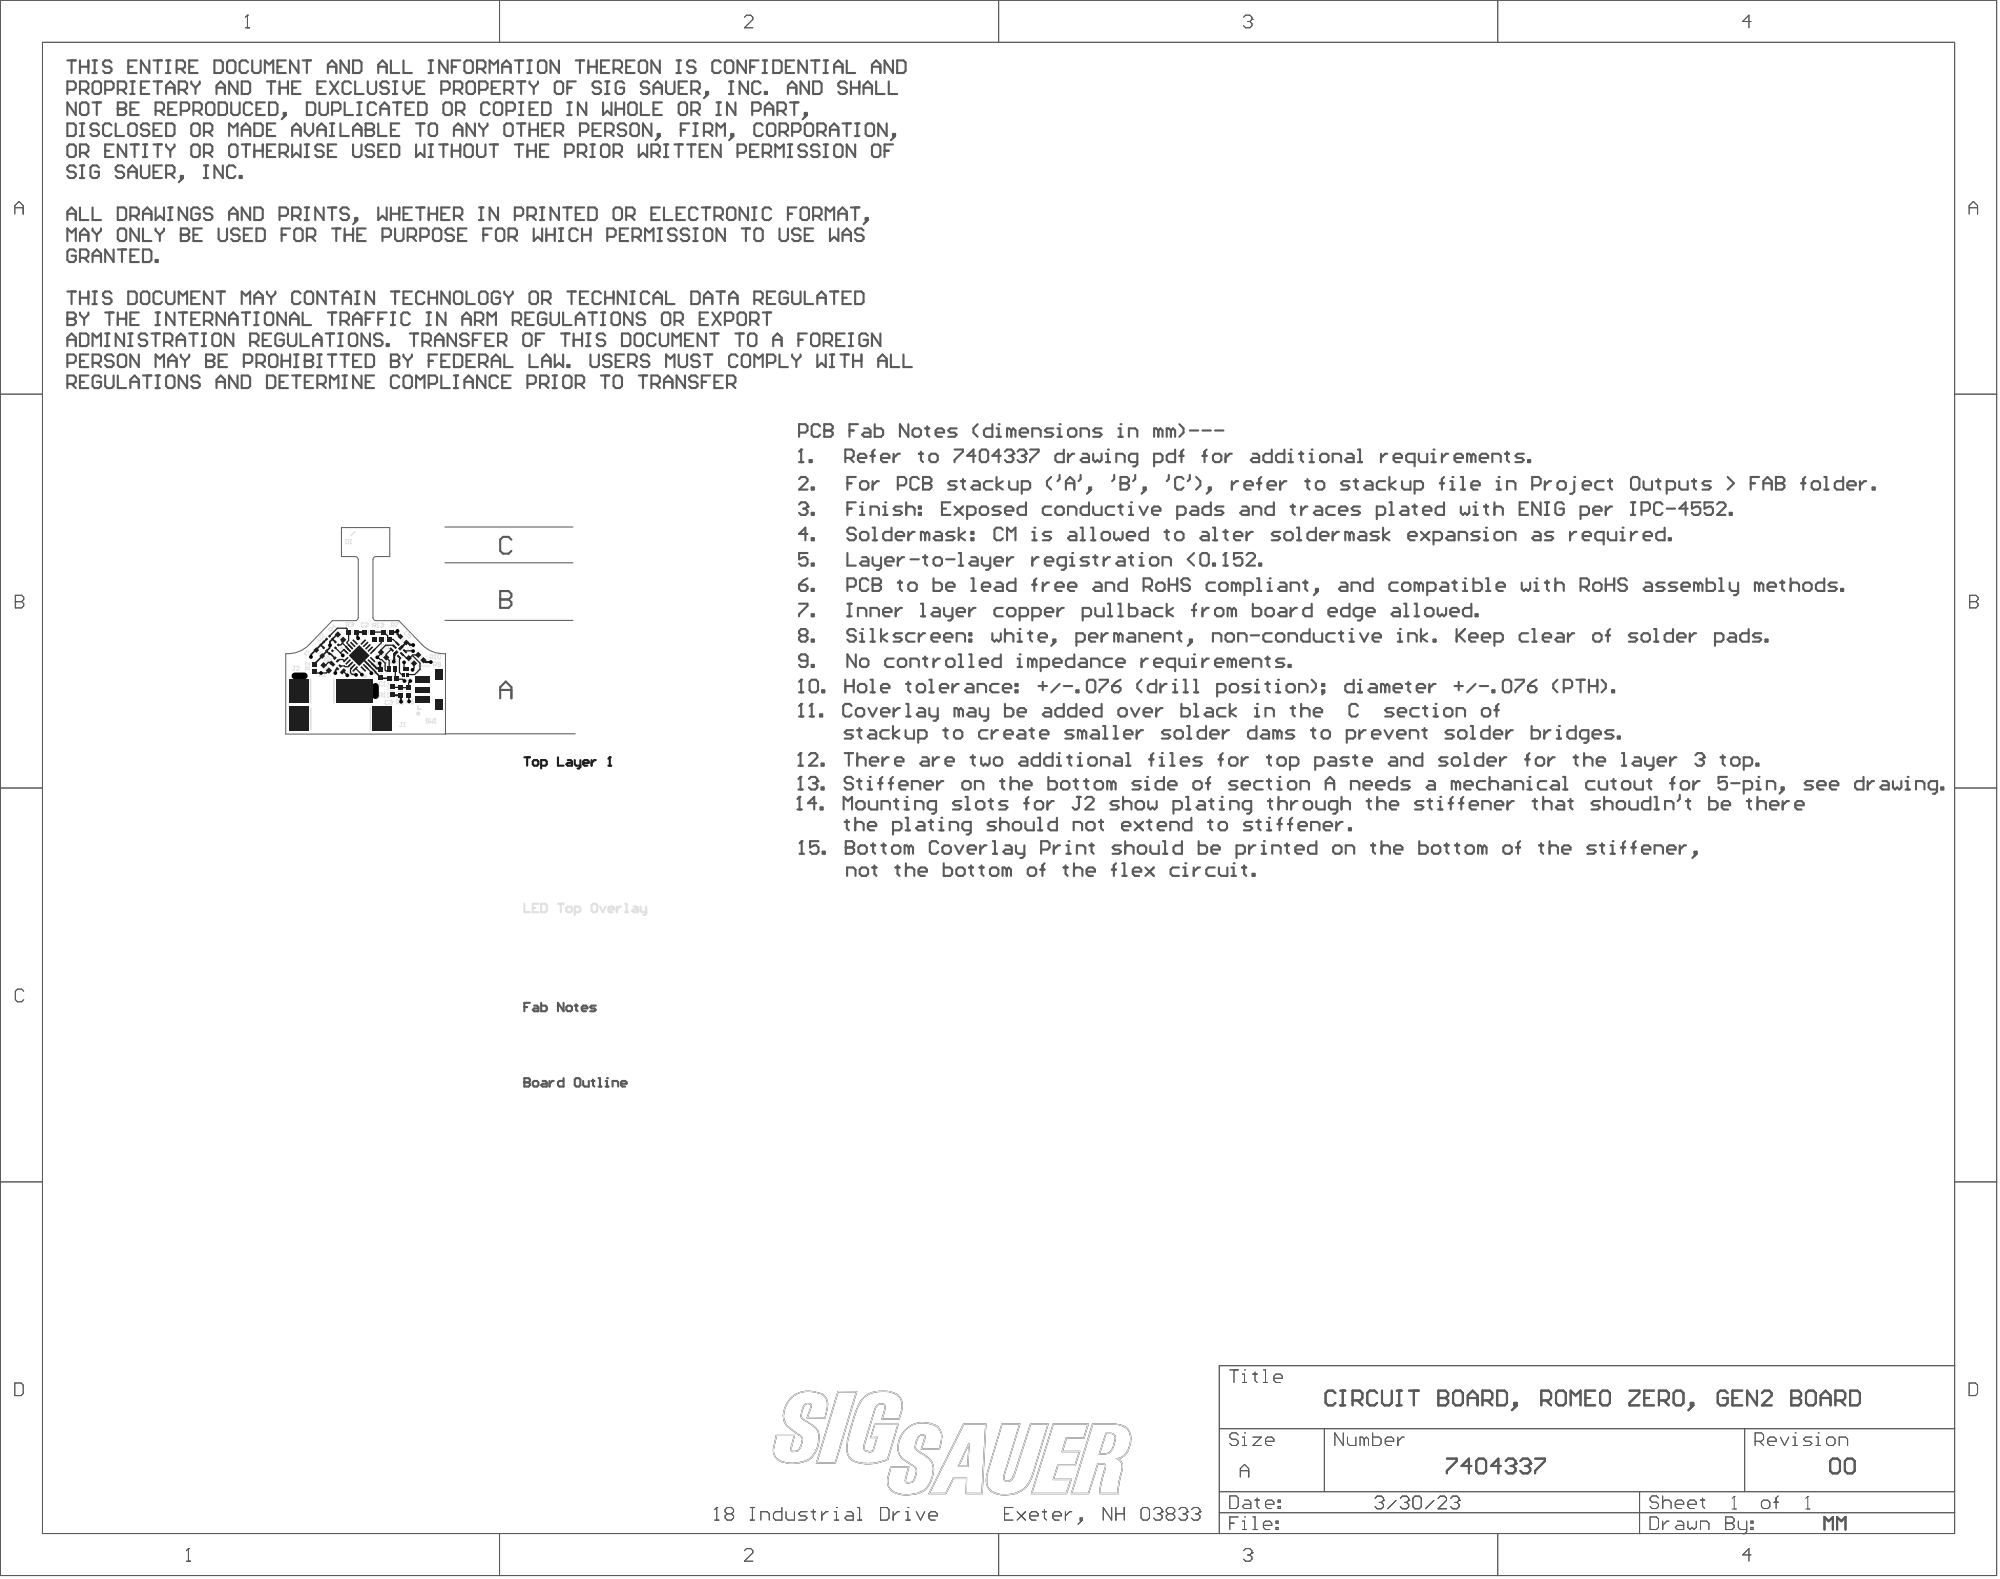
[picture p50: page 12]

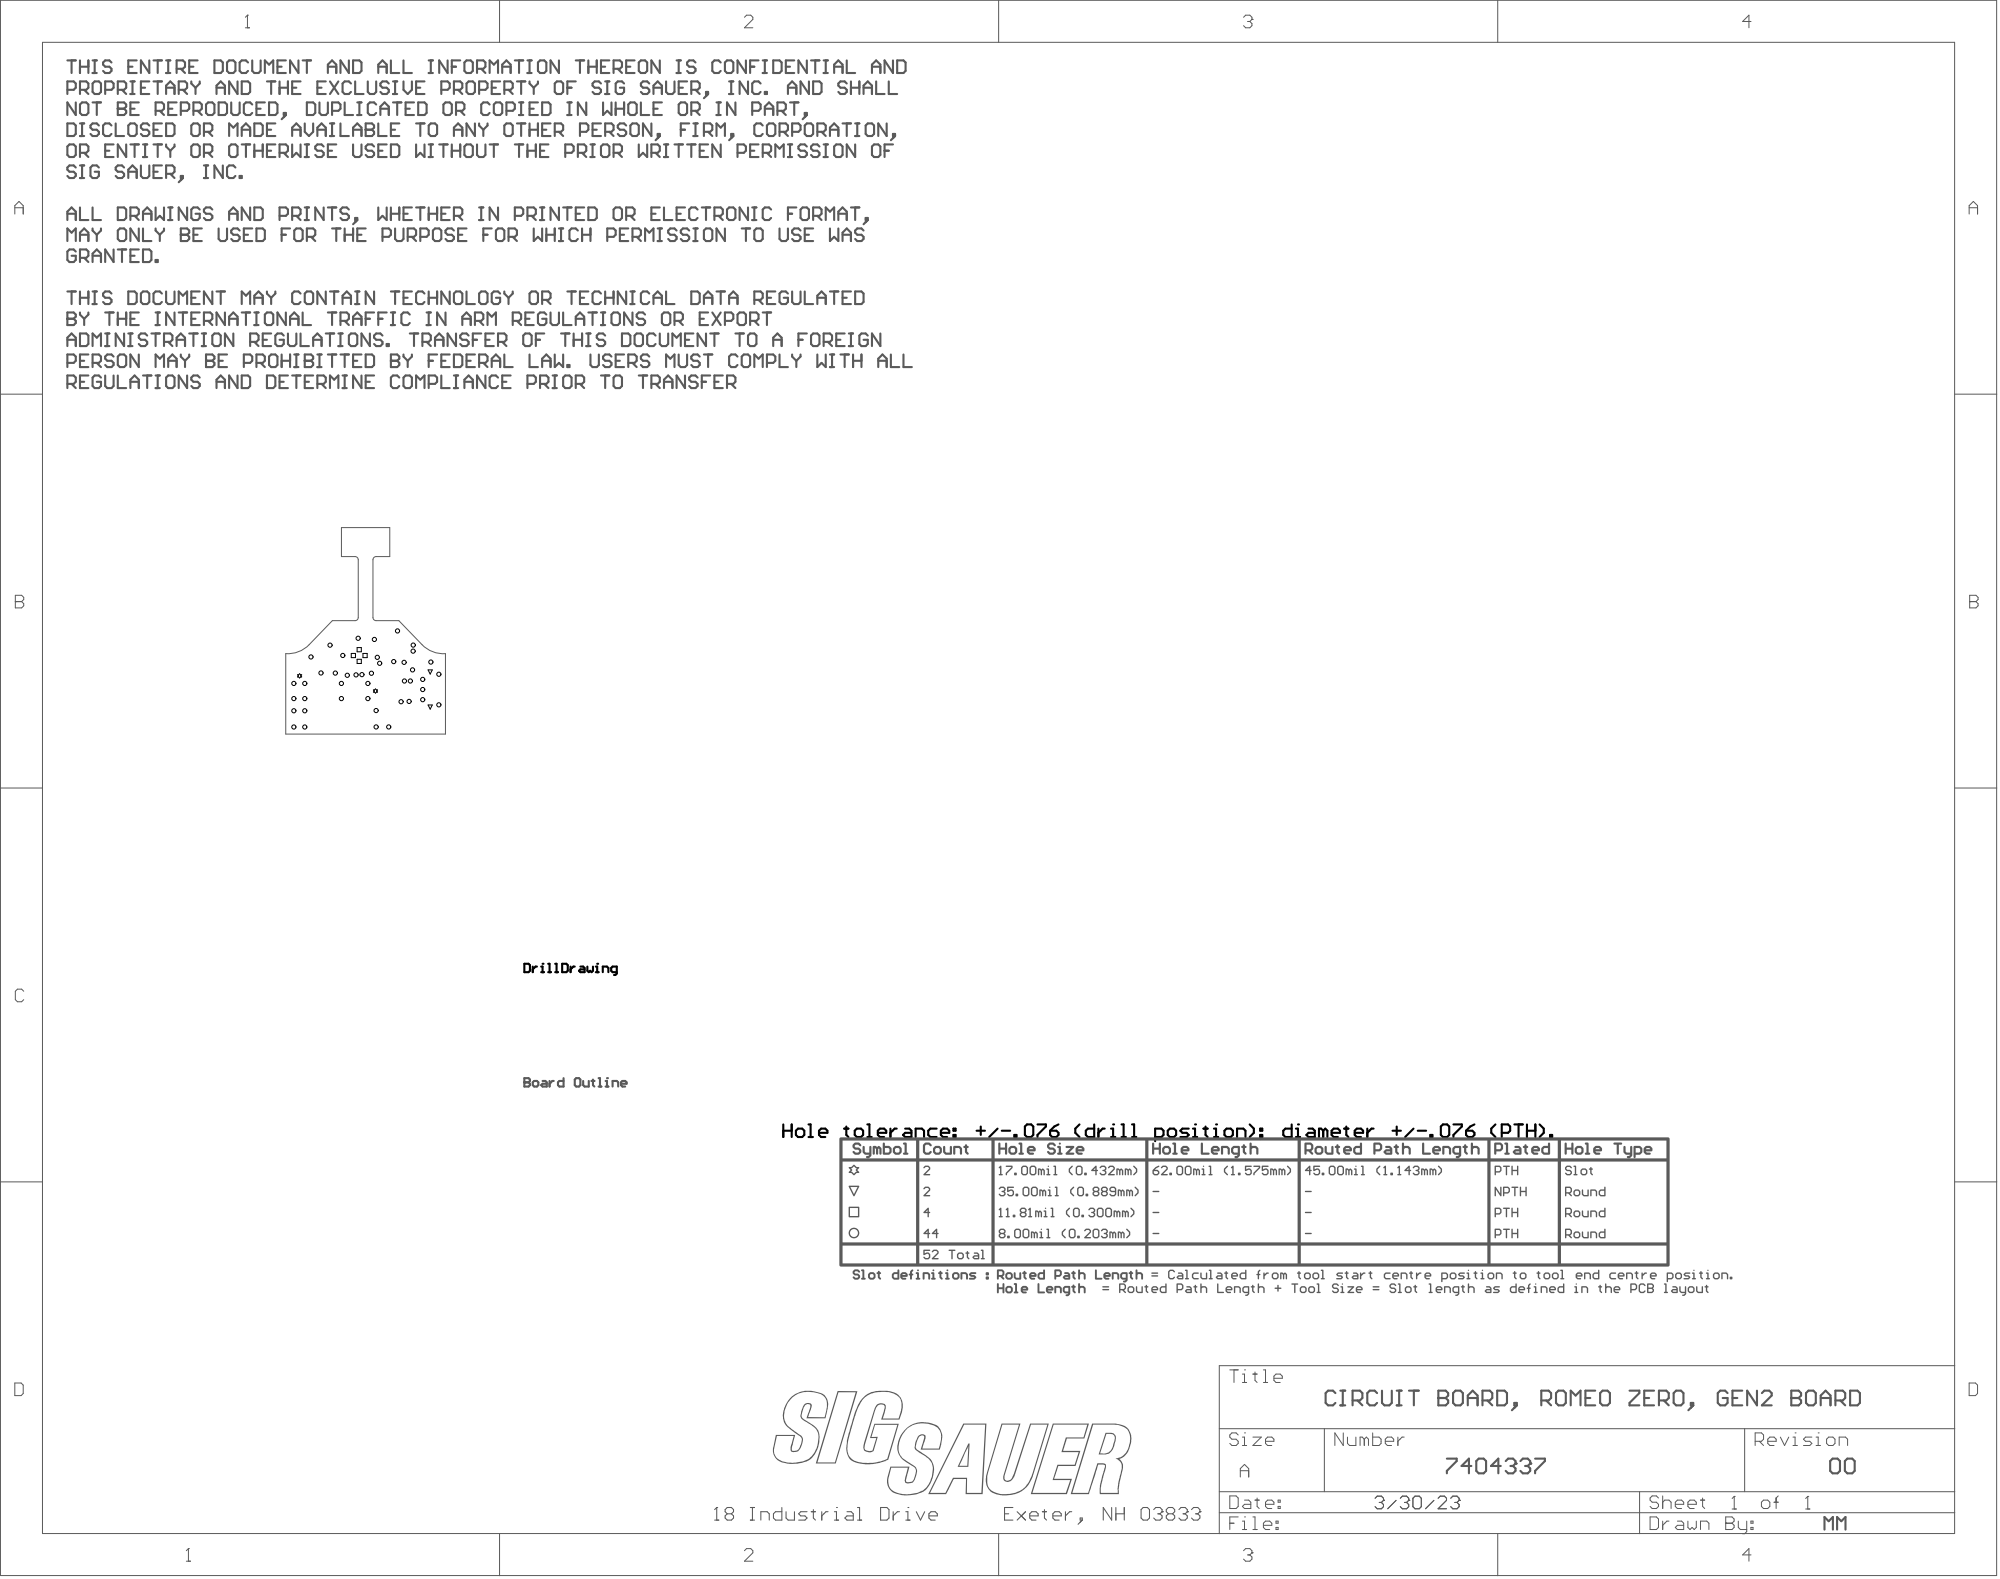
[picture p51: page 13]

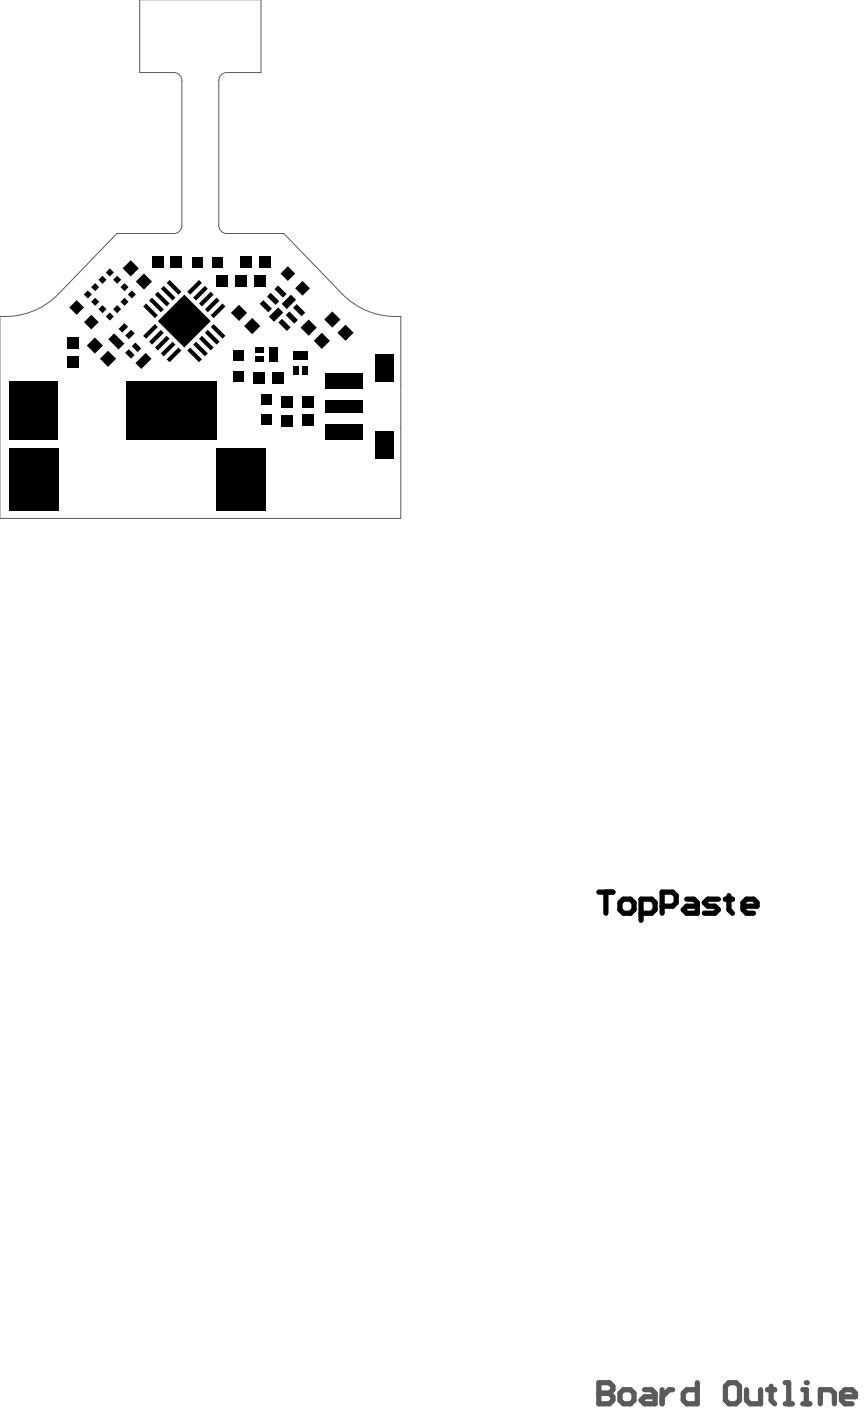
[picture p52: page 14]

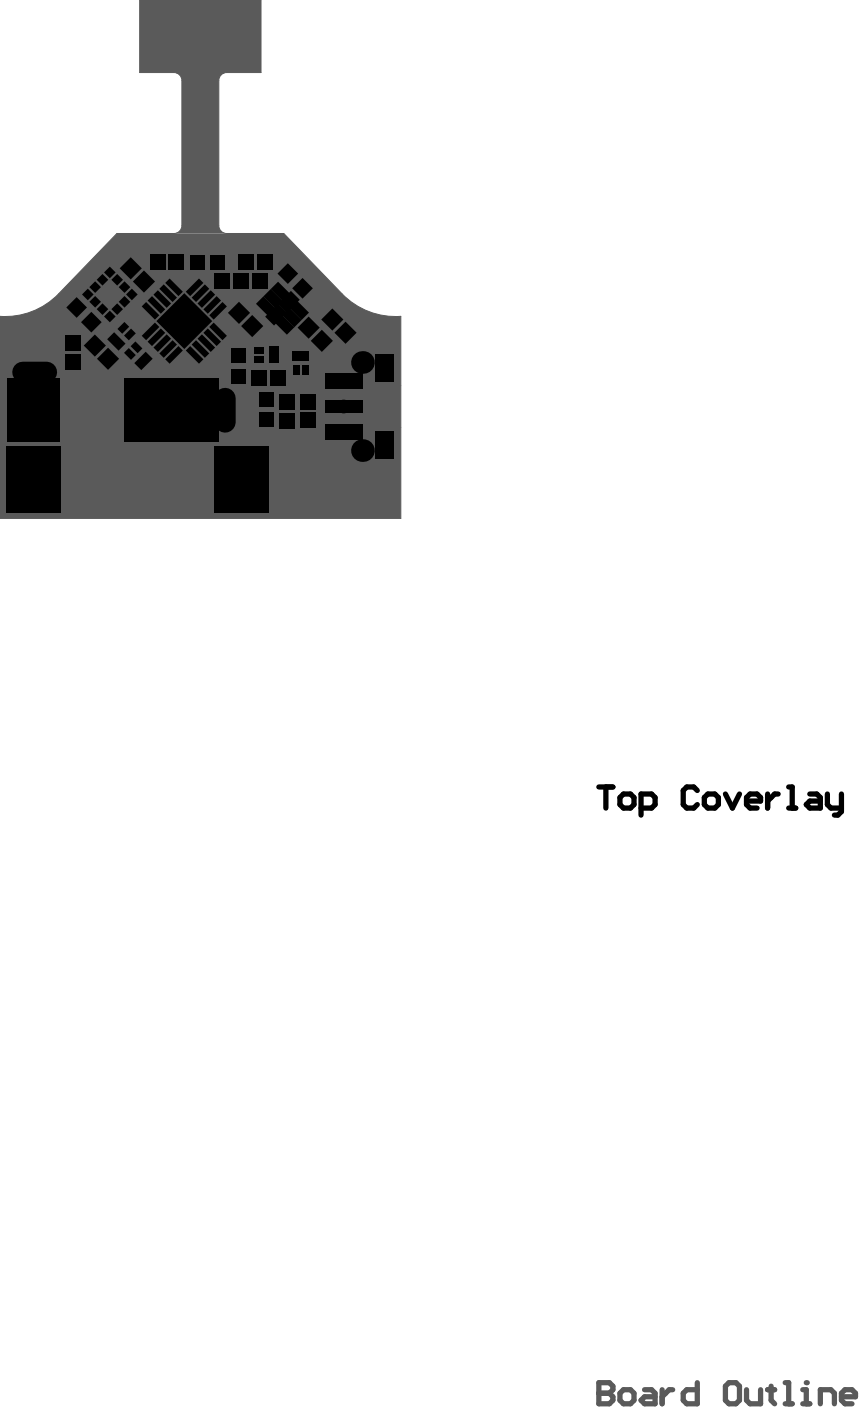
[picture p53: page 15]

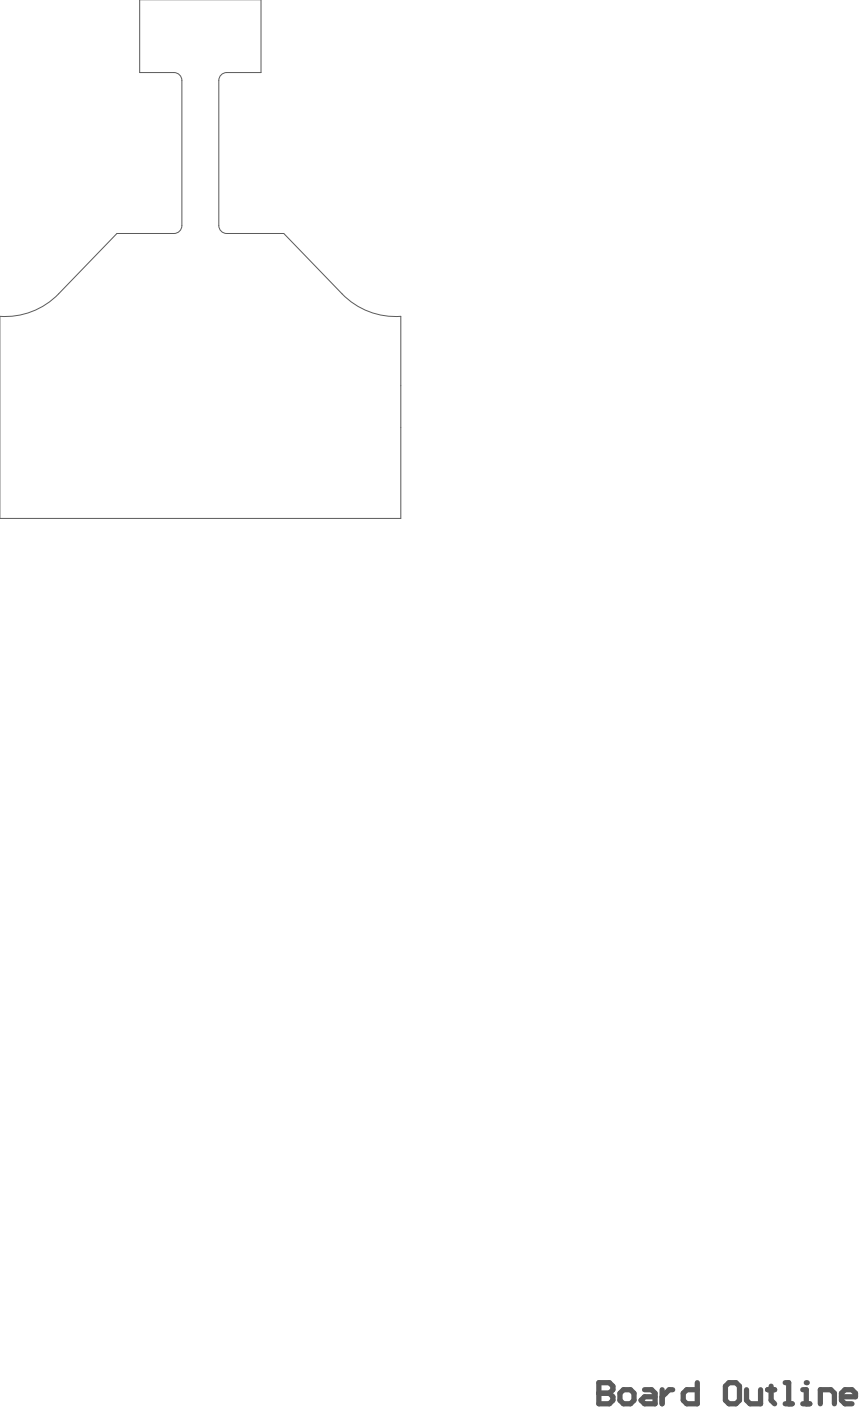
[picture p54: page 16]

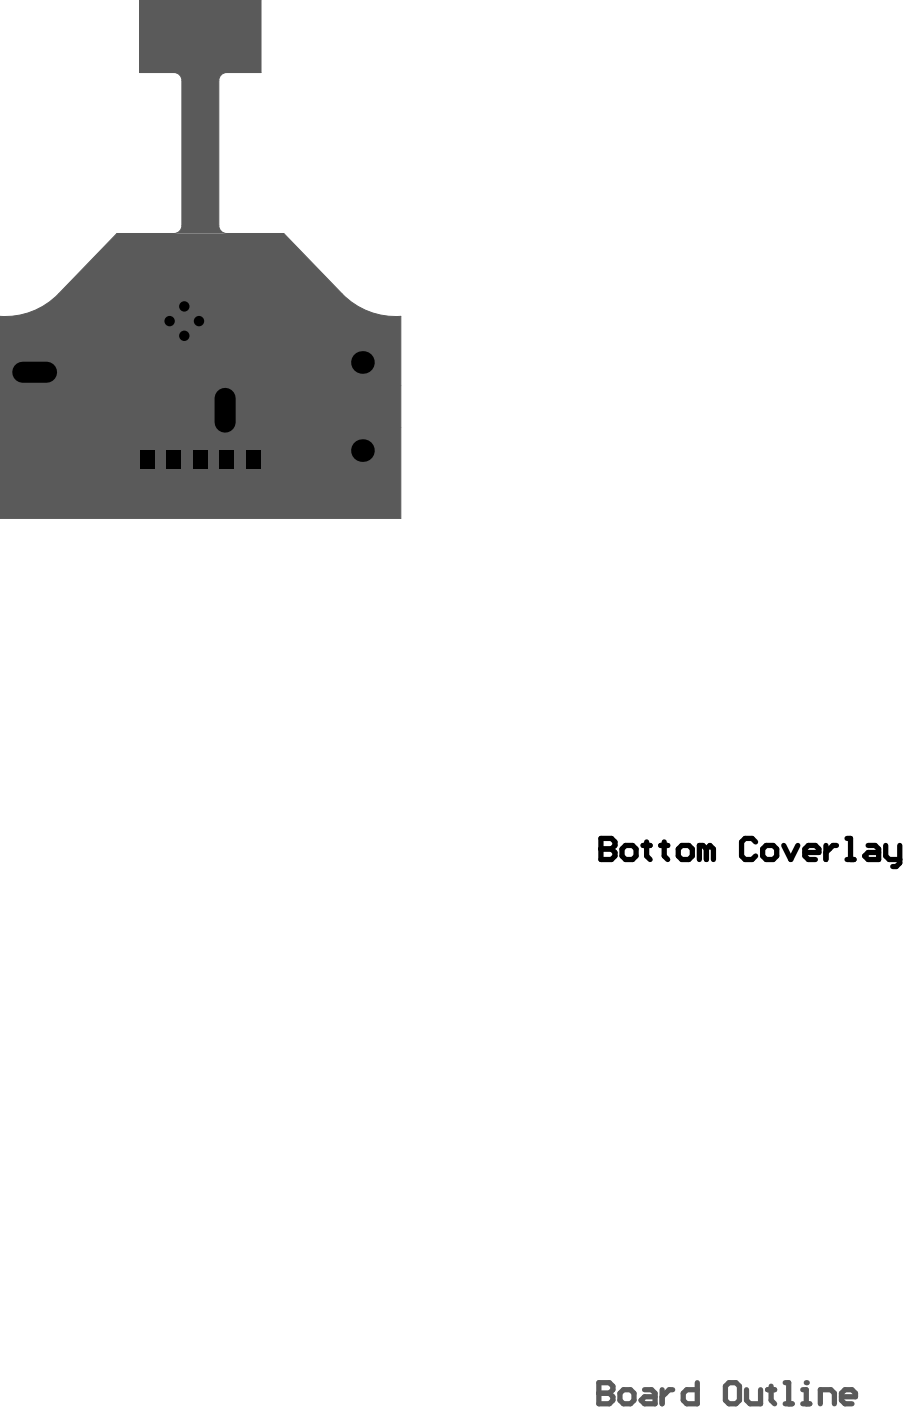
[picture p55: page 17]

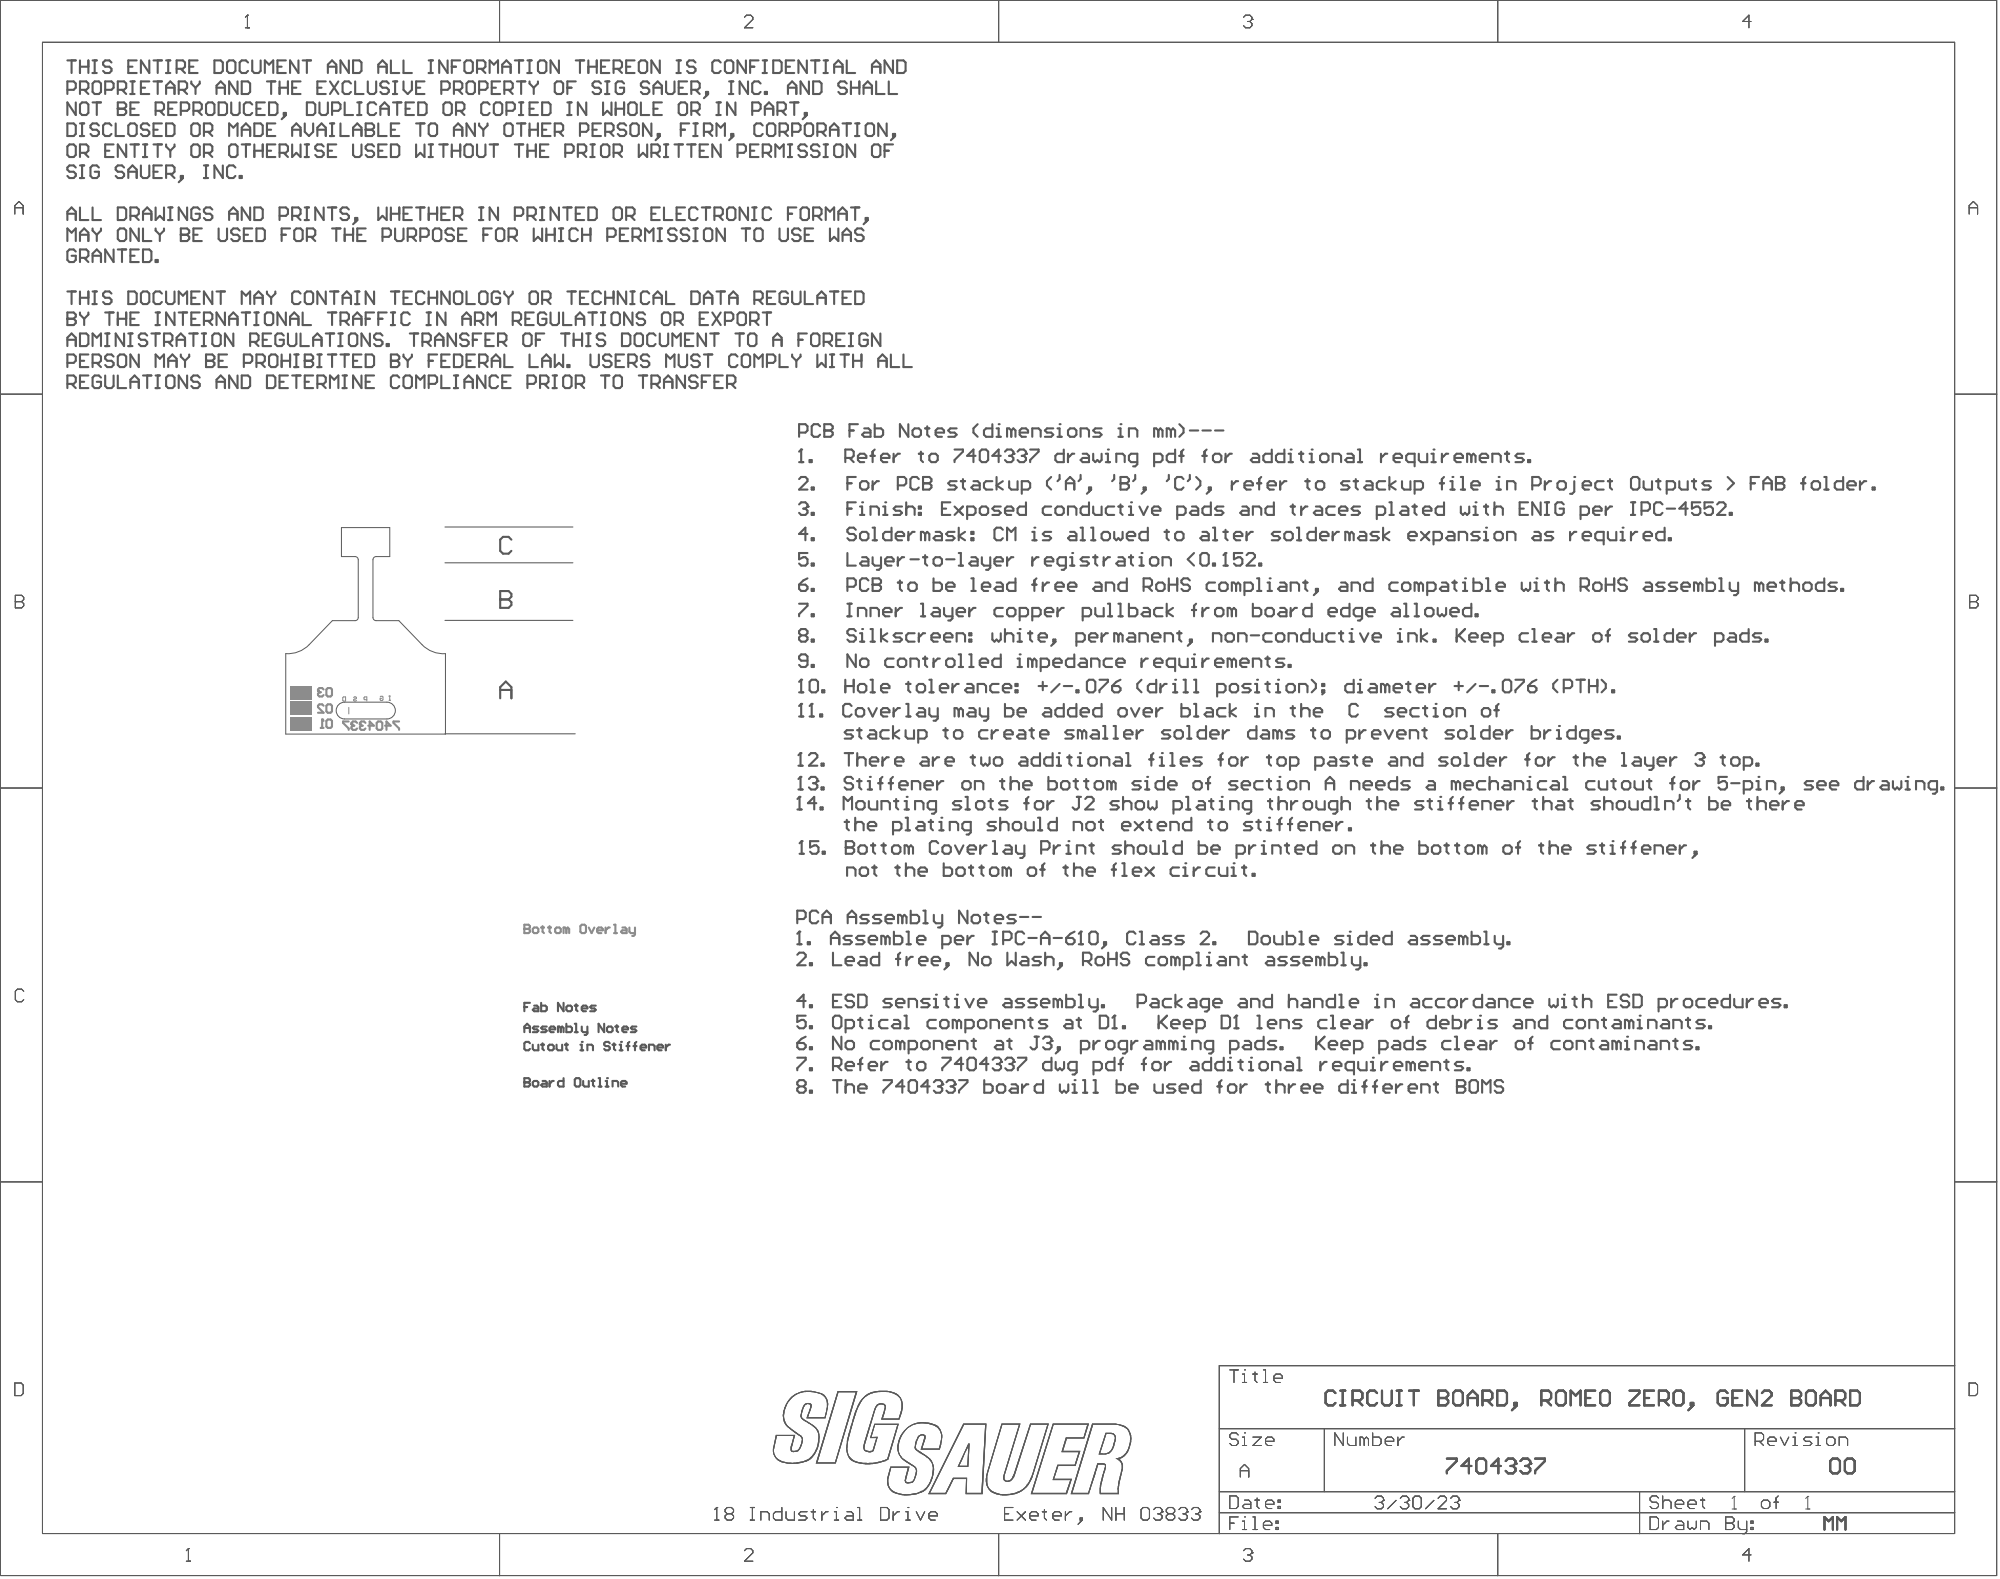
[picture p56: page 18]
