megan4977/7404337_RZ_G2_HW/(list of files, drawings)

Other design files:
AltiumProject/7404337_RZ_G2.PrjPcb
AltiumProject/7404337_RZ_G2.SchDoc
AltiumProject/7404337_RZ_G2_CD1.PcbLib
AltiumProject/7404337_RZ_G2_CD.PcbLib
