megan4977/7404337_RZ_G2_HW/(commit log)

2023-04-04 Separating HW and FW
    Separating the FW from the HW project. The entire project started in the FW folder so that is where history can be found
    [7404337 221212.DXF, 7404337 221219.DXF, 7404337 230327.DXF, 7404337 REV00 230120.DXF, 7404337 REV00 230123.DXF, 7404337 REV00 230126.DXF, 7404337 REV00.DXF, 7404337_RZ_230315.STEP]
2023-04-04 Changed R13
    Changed R13 to 20k for and issues with possible pin setup
2023-04-04 Changed R13 again
    last commit didn't take all the files
    [7404337_RZ_G2.GBL, 7404337_RZ_G2.GBO, 7404337_RZ_G2.GBP, 7404337_RZ_G2.GBS, 7404337_RZ_G2.GTL, 7404337_RZ_G2.GTO, 7404337_RZ_G2.GTP, 7404337_RZ_G2.GTS]
